thuer-awesome/wulpus/projects/README.md

# Independent projects

Projects that are related to the delivery workspace but are not part of the
WULPUS product lines stay isolated here. The current handover is the
[9959 Control Integrated Board](9959-control-integrated-board). Its source,
outputs, and audit files must not be mixed into a WULPUS v1 or PRO production
order.
