thuer-awesome/wulpus/LICENSES/README.md

# License map

The integration repository intentionally keeps the upstream license boundaries.

| Content | Applicable license | License file in this repository |
|---|---|---|
| WULPUS v1 Altium/CAD source | Solderpad Hardware License 0.51 | [`WULPUS-HW-SHL-0.51.txt`](WULPUS-HW-SHL-0.51.txt) |
| WULPUS PRO Altium/CAD source | Solderpad Hardware License 0.51 | [`WULPUS-PRO-HW-SHL-0.51.txt`](WULPUS-PRO-HW-SHL-0.51.txt) |
| WULPUS v1 host software | Apache License 2.0 | [`WULPUS-SW-Apache-2.0.txt`](WULPUS-SW-Apache-2.0.txt) |
| WULPUS PRO host software | Apache License 2.0 | [`WULPUS-PRO-SW-Apache-2.0.txt`](WULPUS-PRO-SW-Apache-2.0.txt) |
| WULPUS documentation images | Creative Commons Attribution 4.0 | [`WULPUS-DOCS-IMAGES-CC-BY-4.0.txt`](WULPUS-DOCS-IMAGES-CC-BY-4.0.txt) |
| MSP430 driverlib | Vendor/third-party terms | [`MSP430-DRIVERLIB-THIRD-PARTY.txt`](MSP430-DRIVERLIB-THIRD-PARTY.txt) |

Firmware source may include Nordic SDK headers, TI driverlib, and other
third-party material. Retain the notices shipped next to the source files when
redistributing a derivative. The integration metadata, scripts, and original
notes added here are released under Apache-2.0 unless a more specific notice
applies.
