thuer-awesome/wulpus/docs/provenance/README.md

# Reproduction-package provenance

The files in this directory preserve the package-level README, source metadata,
manifest, and original repository metadata supplied with the local reproduction
packages. They are evidence about the source snapshot, not a second canonical
copy of the CAD or firmware. The canonical files are the board-oriented trees
under `hardware/`, `firmware/`, and `software/`.
