thuer-awesome/wulpus/firmware/wulpus-pro/msp430/README.md

# WULPUS PRO source files for MSP430 Ultrasound MCU firmware project
This directory contains the source firmware files for 
- MSP430FR5043 Ultrasound MCU (`fw/msp430/wulpus_msp430_firmware`) mounted on the WULPUS PRO PCB

# How to get started?

Please refer to the `WULPUS User Manual` of the WULPUS system v 1.2.2 for the instructions on how to flash the MSP430 MCU:
`https://github.com/pulp-bio/wulpus/blob/main/docs/wulpus_user_manual.pdf`

# License
The files in the `hw/nRF52/wulpus_msp430_firmware` directory contains third-party sources that come with their own licenses (primarily BSD and Apache 2.0 License). See the respective folders and source files' headers for the licenses used.
