thuer-awesome/wulpus/firmware/wulpus-v1/msp430/README.md

# WULPUS source files for MSP430 Ultrasound MCU firmware project
This directory contains the source firmware files for 
- MSP430FR5043 Ultrasound MCU (`fw/msp430/wulpus_msp430_firmware`) mounted on the WULPUS acquisition PCB 

# How to get started?

1. Follow the file `fw/msp430/how_to_setup_msp_430_toolchain_and_flash.md` to install the toolchain and SDK
2. Follow the same file to flash the MSP430 MCU on the WULPUS acquisition PCB.

# License
The files in the `hw/nRF52/wulpus_msp430_firmware` directory contains third-party sources that come with their own licenses (primarily BSD and Apache 2.0 License). See the respective folders and source files' headers for the licenses used.
