thuer-awesome/wulpus/analysis/design-reference/PCB_LAYOUT_RULES_CN.md

# 两层 PCB 放置与布线规则

## 1. 建议板框和层定义

- 首版建议约 80 mm × 50 mm，1.0 或 1.2 mm FR-4、1 oz 铜、ENIG、阻焊覆盖过孔。不要为了复制原 WULPUS 的 17.5 mm × 24.5 mm 四层板尺寸而压缩两层验证板。
- Top：器件、短的功率回路、USB 差分、TX/RX 和控制信号。Bottom：连续的大面积回流铜为主，只在必要处走短线。
- 底层不是“无条件整板一块地”。充电/USB/ESP32 区铺 DGND，升压/驱动/HV2707/MD0101/换能器区铺 AGND_HV；两块铜只在 NT1 处连接。
- 所有从数字区进入驱动区的控制线都从 NT1 附近成束跨区，使它们的返回电流能沿紧邻的地连接闭合。禁止让信号跨越地平面槽后再绕远回流。

## 2. 推荐平面分区

从左到右或从后到前排列：

1. USB-C、USBLC6、PTC 和 BQ24074 紧邻接口。
2. 电池座、BQ 的 BAT/OUT 电容和 TPS63070 紧邻充电区。
3. ESP32-S3 位于板的另一条长边，天线端伸出板边；USB D+/D- 直接从连接器沿板边到模块。
4. NT1 位于 SYS 进入驱动区的咽喉位置。
5. LT1945、TPS61222、TPS22919 和各自电感/二极管/电容放在驱动区靠内侧。
6. MCP1416、HV2707、MD0101、换能器接口依次贴近板的换能器边；RX_OUT SMA 靠 MD0101，并远离 LT1945 SW 节点。

## 3. 关键回路优先级

- BQ24074：J1→F1→IN→输入电容的环路最短；BAT/OUT 电容的地端直接回 U2 VSS/EP。EP 下热过孔连接到底层大铜，禁止热焊盘用细颈或热焊盘花孔连接。
- TPS63070：VIN 电容、U3 VIN/PGND、L1、VOUT 电容形成一个紧凑簇。L1-L2 走线短且宽；FB 分压从输出电容正端做 Kelvin 取样，远离电感和开关铜。
- TPS61222：SYS→L2→pin5、pin4→C16→GND 两个回路紧凑；5V_RAW 只到 U6，不绕行。
- LT1945：U7 pin6、L3、D1 阳极构成的 `SW15_NODE` 铜面积尽可能小，顶层完成且下方不走任何信号。C18 紧靠 pin8/PGND；D1 阴极与 C19 正端贴近。FB2 分压远离 pin6 和电感。
- MCP1416：每颗驱动器、1 µF/100 nF 去耦和 HV2707 对应 TX 开关贴在一起。V15→去耦→驱动器→TX_BUS→开关→AGND 回路不得穿过板中央。
- RX：HV2707 RX 开关→C33/R44→MD0101→SMA 的总长度尽量短；其两侧和底层保持 AGND 连续，必要时加地过孔栅栏。RX_OUT 不与 TX_BUS、SW15_NODE、USB 时钟或 ESP32 天线平行长距离走线。

## 4. 线宽、间距与过孔起始值

以下值用于 1 oz 外层铜的首版起点，最终仍按板厂叠层、温升目标和阻抗计算调整：

| 网络类别 | 顶层建议线宽 | 说明 |
|---|---:|---|
| USB5_IN、BAT+、SYS 主干 | ≥1.0 mm | BQ 周边优先使用铜面，避免细颈 |
| 3V3 主干 | ≥0.8 mm | 模块供电处用面或多根并行短线 |
| 5V_RAW、VDD5_SW | ≥0.5 mm | 负载小但脉冲去耦回流要短 |
| V15 供电 | ≥0.3 mm | 平均电流不大，驱动器局部储能更重要 |
| TX_BUS/CHx | 0.5~0.8 mm | 短、少过孔、每路旁边有地回线 |
| RX_BUS/RX_OUT | 0.25~0.40 mm | 先保持短和连续参考地；若接 50 Ω 同轴再按叠层算阻抗 |
| 普通控制线 | 0.15~0.20 mm | 避免穿过电感和开关节点下方 |

- 常规最小工艺间距可为 0.20 mm；V15/TX 与数字信号主动保持 ≥0.50 mm，换能器连接器附近保持 ≥1.0 mm，目的是减小耦合并留装配余量。15 V 本身不需要夸大的爬电距离。
- 若后续输出升至 60 V 以上，必须依据最大工作电压、污染等级、涂覆和板厂能力重新算电气间隙/爬电距离，本表失效。
- 电源换层至少用 2 个并联过孔，建议成品孔 0.30 mm、焊盘 0.60 mm；高 di/dt 回路尽量不换层。

## 5. USB 与射频

- USB D+/D- 目标差分阻抗 90 Ω ±10%。线宽/间距必须用最终板厚、铜厚、阻焊和板厂介电常数计算，不能照抄“0.15/0.15 mm”之类通用值。
- 差分对等长、同层、少过孔，连接器到 ESD 再到 22 Ω/ESP32；不留测试点支路。两线长度差建议 <0.5 mm，间距沿全程稳定。
- USBLC6 放在连接器后第一站，GND 引脚旁至少 2 个地过孔；ST 手册明确指出 10 mm 细长地线产生的寄生电感会使钳位失效。
- ESP32 PCB 天线 keepout 上下层完全禁铜；模块天线与 LT1945、电感、换能器排线和电池相距尽可能远。不得在天线前方放金属外壳或电池。

## 6. 地、屏蔽与机械

- DGND/AGND_HV 分区的目标是管理回流路径，不是“模拟地越碎越好”。每个区域内部的底层铜必须连续，不开装饰性槽。
- HV2707 pin17 走 DGND，pin13/pin24、MCP1416、MD0101 和换能器回地走 AGND_HV。3V3/VLL 去耦回 DGND，5V/VDD 去耦回 AGND_HV。
- 板边每 5~10 mm 放地缝合过孔；TX/RX 连接器周围加密到约 2~3 mm，但天线 keepout 内禁止放置。
- SMA 边缘焊盘必须按实际板厚核对；如果采用 1.0 mm 板而封装为 1.6 mm 边缘座，机械尺寸会错误。
- 在 PCB 丝印标出：BAT 极性、NTC、所有测试点、RX_OUT、通道号、15 V、USB500 默认、受保护 1S 电池限定，以及 `NOT FOR HUMAN USE / LAB TEST ONLY`。

## 7. 布板顺序

1. 固定板框、USB/SMA/电池/换能器接口和 ESP32 天线位置。
2. 放置每个开关电源的 IC、电感、二极管和输入/输出电容，先完成最小功率环路。
3. 放 MCP1416、HV2707、MD0101 和通道连接器，先走 TX/RX。
4. 放 BQ24074 和 TPS63070，走 USB5/BAT/SYS/3V3 主干。
5. 走 USB 差分并进行阻抗/等长约束。
6. 放 NT1、划分底层地铜，再走跨区控制线。
7. 最后走低速控制、铺铜、加回流过孔和测试点；重新检查是否有信号跨地缝。

## 8. DRC 前人工检查

- 所有 IC 的裸露焊盘、NC、VSS 浮空和多地脚是否按数据手册连接。
- TPS63070 RNM、HV2707 LQFP48、MD0101 K6、USB4105 的 pin1/朝向和 land pattern 是否对照官方图纸逐项量过。
- HV_EN、BOOST5_EN、MUX_PWR_EN、TX_PULSE 是否都有硬件下拉；MUX_CLR 是否上拉。
- 任何通道是否误把 TX 和 RX 开关同时默认开启。
- `SW15_NODE` 下方是否无走线，FB 取样是否从输出电容正端取得。
- ESP32 天线 keepout 是否上下层都无铜，USB 是否有连续参考地。
- DGND 与 AGND_HV 是否只在 NT1 一处导通，所有跨区信号是否经过 NT1 附近。
