thuer-awesome/wulpus/reference/source-repository-maps/wulpus-pro/hw-README.md

# WULPUS PRO PCB design files
This directory contains the design files for the printed circuit boards (PCBs) of the WULPUS PRO project.
Each subdirectory corresponds to a separate PCB project. Inside you can find the Altium CAD design files:
- Source design files
- PDF schematics and assembly drawings (`docs` folder), 
- Fabrication outputs (`fabrication_outputs` folder):
    - Bill of Materials(.xlsx) 
    - Gerber files
    - NC drill files
    - Pick and Place files

# License
The PCB design files are licensed under Solderpad v0.51 (`SHL-0.51`) license. Please, check the `hw/LICENSE` file for details.
