thuer-awesome/wulpus/analysis/official-source-audit/design-study/MANIFEST_SHA256.csv

Path | Length | SHA256
pcb_reverse_engineering/commercial_fpga_reference/analysis/firmware/FM24CL16B_nonzero_records.csv | 367 | 070040d7545b339eee0f2d523455eee9dd12c03434a246f5d6bee777dfdbf103
pcb_reverse_engineering/commercial_fpga_reference/analysis/firmware/MEMORY_DUMP_ANALYSIS_CN.md | 2227 | d5cebd964eb397844bfc2871592d9f9edc2bbe7b80cf1e03fb61dacfa1235370
pcb_reverse_engineering/commercial_fpga_reference/analysis/firmware/W25Q80D_ascii_strings.csv | 10663 | bfedeaf28cb81a85b8454ea77de9c0812d8c0171ecb84a4d585d103069e0462d
pcb_reverse_engineering/commercial_fpga_reference/analysis/firmware/W25Q80D_CC3200_flash_canonical_1MiB.bin | 1048576 | 8c11c60c6a7c86abe0b310d417b99bf657c05531fffa54eede3458e214d76169
pcb_reverse_engineering/commercial_fpga_reference/analysis/firmware/W25Q80D_programmer_footer_2B.bin | 2 | 96a296d224f285c67bee93c30f8a309157f0daa35dc5b87e410b78630a09cfc7
pcb_reverse_engineering/commercial_fpga_reference/analysis/firmware/W25Q80D_SFDP_1024.bin | 1024 | 8c5001a3341bb43247a5b00e9c751d8a544581dc7c8dc129ab63b67b36f456b1
pcb_reverse_engineering/commercial_fpga_reference/analysis/pcb/20260725_96ARC_V7.d356 | 223718 | 51253fbab29b4babd1413a4c03633632e44d88060d4622430a852bd9d9cec5f9
pcb_reverse_engineering/commercial_fpga_reference/analysis/pcb/20260725_96ARC_V7.kicad_pcb | 3519418 | ef186f87a0cc67aa6efbe63ac40c965a234b9717b8792999dfd292cabab4e1a3
pcb_reverse_engineering/commercial_fpga_reference/analysis/pcb/20260725_96ARC_V7.kicad_prl | 2304 | bfebb5b589d1b6a3b3ff4e9ab6e0fdc397a6cd186c9a26b5d129ebcd07a3a01e
pcb_reverse_engineering/commercial_fpga_reference/analysis/pcb/20260725_96ARC_V7_import_report.json | 2629 | d95b70551f38c8a77a140c33ce4594b8f1fc6ae82c5d3ee042c932c10ccc7fc2
pcb_reverse_engineering/commercial_fpga_reference/analysis/pcb/20260725_96ARC_V7_stats.json | 5190 | 26273fa46523d95ee459a0d846cf40f6c63c66af168aaef819219870581ac888
pcb_reverse_engineering/commercial_fpga_reference/analysis/pcb/20260725_PowerDaughter_v30.d356 | 73636 | 3d5ccb692c5e7265621de7036a2335f20611d4bc59a8caebc6cf4b6452b06eca
pcb_reverse_engineering/commercial_fpga_reference/analysis/pcb/20260725_PowerDaughter_v30.kicad_pcb | 1220579 | b073dcb0ed322e55a9cb06e1ccc3fc54cf2d29a74b9d61e864742a5abd13a21a
pcb_reverse_engineering/commercial_fpga_reference/analysis/pcb/20260725_PowerDaughter_v30.kicad_prl | 2313 | 6b804854f42bdbc50f70ec8d331103986c1a0243c5651277548fbc9578bf2dad
pcb_reverse_engineering/commercial_fpga_reference/analysis/pcb/20260725_PowerDaughter_v30_import_report.json | 2487 | 1ec717288ed0ba41afb84001b00e40aaa2ccd9b1ca1c91f36ad1c389a0e7ec13
pcb_reverse_engineering/commercial_fpga_reference/analysis/pcb/20260725_PowerDaughter_v30_stats.json | 4952 | 9708e1fbf4aad868ff4b5027502a7a8295883afc8507a1642732c81a0dfc9664
pcb_reverse_engineering/commercial_fpga_reference/analysis/pcb/CONNECTOR_AND_CHANNEL_MAP_CN.md | 2248 | 7439f27845415d8f6723617d70373ce90af7c1b1311ebb27184f0bacc2374a42
pcb_reverse_engineering/commercial_fpga_reference/analysis/photos/96ARC_V7_top_component.jpg | 3944013 | b302280954f173fad734c9d27bd30d2b8e29bae445c638ed1a2a817de3922eef
pcb_reverse_engineering/commercial_fpga_reference/analysis/photos/commercial_board_photos_contact_sheet.jpg | 1893171 | a0b9a297a6ad0ff482c754ac46f5b9f18623c7b6bb6e516a4a5b5ccea2de5a41
pcb_reverse_engineering/commercial_fpga_reference/analysis/photos/PowerDaughter_v30_top_component.jpg | 2289514 | c17d5816f664cb6d88a6b4ff5ec6bbb5f6c5af682bb27587de42f3a97951df64
pcb_reverse_engineering/commercial_fpga_reference/analysis/schematic/96ARC_V7_pdf_page_1.png | 797897 | 8c30ddf372aa0c18766510f7c2f1c53baaff6bf01f0266725934fb0ca9dd2a5e
pcb_reverse_engineering/commercial_fpga_reference/analysis/schematic/96ARC_V7_pdf_page_2.png | 647276 | 49e09cf869fc2c1a0aa5cf8840a116a940f43c16644df14e61ce9437d0588bbd
pcb_reverse_engineering/commercial_fpga_reference/analysis/schematic/96ARC_V7_pdf_page_3.png | 14829 | fee73408196874731cf30b0648dc72a69cd7e8e08bd8be15d84d0775382127b1
pcb_reverse_engineering/commercial_fpga_reference/analysis/schematic/commercial_delivery_pdf_contact_sheet.png | 1052459 | 8d15213b5ad89c1046d7efcdef36fc63c6b23f46663774f1897fb5aeaf3bceeb
pcb_reverse_engineering/commercial_fpga_reference/analysis/schematic/PowerDaughter_v30_pdf_page_1.png | 428168 | 6d8ec1d15a721465175b295d8145b6309f2adaa8308355da8ae3df34db4c2257
pcb_reverse_engineering/commercial_fpga_reference/analysis/schematic/PowerDaughter_v30_pdf_page_2.png | 598329 | 4adb0f5dc7def94a45d9f572175a48083448351ef6b363e4b331dd0088e5ae7a
pcb_reverse_engineering/commercial_fpga_reference/analysis/schematic/PowerDaughter_v30_pdf_page_3.png | 14829 | fee73408196874731cf30b0648dc72a69cd7e8e08bd8be15d84d0775382127b1
pcb_reverse_engineering/commercial_fpga_reference/analysis/specs/ultrasound_spec_calculator.py | 4264 | 52ebee3e179971bd65ab6a9a6d1c669c38b53f6a681a05a4955379e43881643d
pcb_reverse_engineering/commercial_fpga_reference/source_original/MANIFEST_SHA256.csv | 12337 | f1332eb8233132825e92a6150133dcc286d4d7bc188b6dbf79df2c3ca5e08d52
pcb_reverse_engineering/commercial_fpga_reference/study/README_CN.md | 3368 | 7f7aa08f9f10f107eabb11eb4d60a9c241abfd1847fbc123f53b2252094770a0
pcb_reverse_engineering/output/pdf/Portable_Ultrasound_Three_System_Study_CN.pdf | 6753373 | 11a2c9cd69bb171fb46a95e345362da3b37aec9314ba565a8614aa55aad737b2
pcb_reverse_engineering/report/assets/reverse_reference_tx_mux.png | 177637 | 7d533b079f513c007bc858e43202df90126312d61a9316aa45ae25f3f949202b
pcb_reverse_engineering/report/assets/wulpus_hv_topology.png | 429315 | 04f356af4a13b77d1f360149f0510f2d5f2c78cb9eaba8ca39e834e19658df37
pcb_reverse_engineering/report/assets/wulpus_pro_hv_topology.png | 427441 | 7455e0758689304ba58e3108651f87ec642237bf4b006d09b34f6707bc1afd31
pcb_reverse_engineering/report/Build_Report.cmd | 560 | 6a27e35e101413052c996e0753cd7089385b89f4bf7a7ae4d6e8d483b179d4bf
pcb_reverse_engineering/report/portable_ultrasound_three_system_study_cn.typ | 41744 | 52fc896348707f9645f481f2a5fd21ade720cf762e89ba5f884054f83c2d619a
pcb_reverse_engineering/tools/archive_commercial_fpga.ps1 | 2989 | ebe54ba5d76f4df0231f1d640715e83270b29b96381b7d12f1d9bdfc6efce641
pcb_reverse_engineering/tools/kicad_portable/analysis/converted/wulpus/acquisition_pcb/pcb/PCB1.import_report.json | 2932 | a77e5778ca47408303cd2f24459794831ad1d7cf2db3c5cd6afe92f492beac8a
pcb_reverse_engineering/tools/kicad_portable/analysis/converted/wulpus/acquisition_pcb/pcb/PCB1.kicad_pcb | 5712633 | 6749f520748b88a9bf1e401fff7e149c53b6ddad14385b484b39414388fca86b
pcb_reverse_engineering/tools/kicad_portable/analysis/converted/wulpus/acquisition_pcb/pcb/PCB1.kicad_prl | 2291 | 83a133be35a613c2eb8d96ee3f2236dd53320a571a03b014da42efa82aeaf204
pcb_reverse_engineering/tools/kicad_portable/analysis/converted/wulpus/acquisition_pcb/pcb/plots/legacy_acquisition_layers.pdf | 1065693 | d9d8411842b473a5a919aaddc590b5712f9203bba3050b1303f4de4977bf0a43
pcb_reverse_engineering/tools/kicad_portable/analysis/converted/wulpus/acquisition_pcb/pcb/renders/legacy_acquisition_bottom.png | 545174 | d0a0564d986316c08c8f26dce2effdb226e90acea7682141d60afbb7ff465548
pcb_reverse_engineering/tools/kicad_portable/analysis/converted/wulpus/acquisition_pcb/pcb/renders/legacy_acquisition_top.png | 701188 | 9f8e93d7f57b1a429a6939cace4fc7f0eb6729d04ff05a1a1398bcc6bd265e14
pcb_reverse_engineering/tools/kicad_portable/analysis/converted/wulpus/acquisition_pcb/pcb/reports/legacy_acquisition_drc.json | 1009773 | 271967be9ea74c1beafb4ebe5faa3810b43f8cc41de5666cd3ce9136014cec7b
pcb_reverse_engineering/tools/kicad_portable/analysis/converted/wulpus/acquisition_pcb/pcb/reports/legacy_acquisition_drc.rpt | 319298 | fd10fd6c5074e02ffbc01f87e6485bb80fcfe05170000ed295fdbac350c2a6e0
pcb_reverse_engineering/tools/kicad_portable/analysis/converted/wulpus/acquisition_pcb/schematic/00_POWER.kicad_sch | 976511 | b8bcaa9546409b54fd0802017a77c14b487b82a63860938db1ed0c92d2f38e7c
pcb_reverse_engineering/tools/kicad_portable/analysis/converted/wulpus/acquisition_pcb/schematic/01_NRF52.kicad_sch | 741215 | 3d77582a4fad53b8f1aec50650968f05ea9cb1f217db0f5a8cb34867f48ae414
pcb_reverse_engineering/tools/kicad_portable/analysis/converted/wulpus/acquisition_pcb/schematic/02_MSP430.kicad_sch | 806538 | 603da13dfb3c188dcc4017c42bae0ea7e92ff547ffedde6f1f8a2542fc7538c7
pcb_reverse_engineering/tools/kicad_portable/analysis/converted/wulpus/acquisition_pcb/schematic/exports/00_POWER.pdf | 263874 | 221924c0f82e645514de216ca0aedc48982c4964fe4eaed3f62d7d6e26121463
pcb_reverse_engineering/tools/kicad_portable/analysis/converted/wulpus/acquisition_pcb/schematic/exports/00_POWER_bom.csv | 3113 | ba1a683f3724f12f6d93ef3740a617f1f6d751dcedba60e4d63d8599ffaf6069
pcb_reverse_engineering/tools/kicad_portable/analysis/converted/wulpus/acquisition_pcb/schematic/exports/00_POWER_erc.json | 324328 | 38e9868bb3adf8f79e4755daac1dfa3c32ae97bbfe7b2ed42da5df6d582590f3
pcb_reverse_engineering/tools/kicad_portable/analysis/converted/wulpus/acquisition_pcb/schematic/exports/00_POWER_erc.rpt | 74403 | 068fe128cc00b86a7d5781af638df499b965998ac4027cd582a41a7cc657d8d2
pcb_reverse_engineering/tools/kicad_portable/analysis/converted/wulpus/acquisition_pcb/schematic/exports/00_POWER_netlist.xml | 213392 | 113af3046a8ce231d5336998dbc6a550c0a93965af9600c1915077d55a982dbd
pcb_reverse_engineering/tools/kicad_portable/analysis/converted/wulpus/acquisition_pcb/schematic/exports/01_NRF52.pdf | 245642 | fb6ecd128f62dd4e051b68ab31b76015385fbe7b45cd33a526f01756cdd29fc4
pcb_reverse_engineering/tools/kicad_portable/analysis/converted/wulpus/acquisition_pcb/schematic/exports/01_NRF52_bom.csv | 1599 | 373fbbcea659f845f85498ae1d22d3a70b77e4c57341e4b68e43e5f8f24c1607
pcb_reverse_engineering/tools/kicad_portable/analysis/converted/wulpus/acquisition_pcb/schematic/exports/01_NRF52_erc.json | 286386 | f10ccf182fe7c8c2dcf4a25c755188230d863ed93956d0b08d9ec481805ae5cf
pcb_reverse_engineering/tools/kicad_portable/analysis/converted/wulpus/acquisition_pcb/schematic/exports/01_NRF52_erc.rpt | 64027 | 7293849b7f973e39682c2c7c3a6f081a4a7adf3686df84d546cee93392f1ee42
pcb_reverse_engineering/tools/kicad_portable/analysis/converted/wulpus/acquisition_pcb/schematic/exports/01_NRF52_netlist.xml | 124934 | b9766175c78c05737d28076b77abe981aacfd95b72e046fa8ba07384fd68d2f1
pcb_reverse_engineering/tools/kicad_portable/analysis/converted/wulpus/acquisition_pcb/schematic/exports/02_MSP430.pdf | 269352 | 0684178063d5d83434e76b93777eff852d08b9e2b61eac7268b9dbf418317163
pcb_reverse_engineering/tools/kicad_portable/analysis/converted/wulpus/acquisition_pcb/schematic/exports/02_MSP430_bom.csv | 1968 | 700b7d1f786df966843ab64f633f34be4e7db57349446231335507676483866d
pcb_reverse_engineering/tools/kicad_portable/analysis/converted/wulpus/acquisition_pcb/schematic/exports/02_MSP430_erc.json | 350100 | c39b56fc04fe84bec7c61995df7a8417faf1528f708df52b9e43ee815a79874d
pcb_reverse_engineering/tools/kicad_portable/analysis/converted/wulpus/acquisition_pcb/schematic/exports/02_MSP430_erc.rpt | 78534 | 0bb30ee96722ec7e72b422abe0fa6b6056973ea8a52dbd178ff0bab4f8740405
pcb_reverse_engineering/tools/kicad_portable/analysis/converted/wulpus/acquisition_pcb/schematic/exports/02_MSP430_netlist.xml | 150643 | b9b900456a43a83087423f2118c045bab4c2630a59fccad53641831d9959cf5e
pcb_reverse_engineering/tools/kicad_portable/analysis/converted/wulpus/hv_pcb/pcb/PCB1.import_report.json | 2929 | ae3ae7302fe6dc974df3091d935b7daa64dde502af3406f4932a878b9d35a3f3
pcb_reverse_engineering/tools/kicad_portable/analysis/converted/wulpus/hv_pcb/pcb/PCB1.kicad_pcb | 2781457 | 0742b30313925734417916c6eca59869eb56a8679048abcd24ff77be33bd3d33
pcb_reverse_engineering/tools/kicad_portable/analysis/converted/wulpus/hv_pcb/pcb/PCB1.kicad_prl | 2291 | 83a133be35a613c2eb8d96ee3f2236dd53320a571a03b014da42efa82aeaf204
pcb_reverse_engineering/tools/kicad_portable/analysis/converted/wulpus/hv_pcb/pcb/plots/legacy_hv_layers.pdf | 456144 | 31bda550b14f2d634774d3514fef547887deac9785393132b279080fcaa22742
pcb_reverse_engineering/tools/kicad_portable/analysis/converted/wulpus/hv_pcb/pcb/renders/legacy_hv_bottom.png | 637488 | 81098f1f070407469c299a77f2ab726056e20c4023c0c7cea0bdd6b4c1784d7f
pcb_reverse_engineering/tools/kicad_portable/analysis/converted/wulpus/hv_pcb/pcb/renders/legacy_hv_top.png | 555611 | 88577ba9b5b483be96ab11934fd9813d6eadcf90b8e5fc73062d21e755b03b7f
pcb_reverse_engineering/tools/kicad_portable/analysis/converted/wulpus/hv_pcb/pcb/reports/legacy_hv_drc.json | 671817 | 4217bd0ee987ff5bc5b2728ed68cb6066316d83bcf87e4b997e401bd3f0a7c93
pcb_reverse_engineering/tools/kicad_portable/analysis/converted/wulpus/hv_pcb/pcb/reports/legacy_hv_drc.rpt | 205362 | 6d74b9d5212d9fed496a3a99409ef3600c367005d5ec3752a64f20dc6331a54c
pcb_reverse_engineering/tools/kicad_portable/analysis/converted/wulpus_pro/acquisition_dev_board/pcb/plots/pro_acquisition_dev_layers.pdf | 1645580 | 24a5a2677adfda0f15a20c6798212993680a875072d47f87a432a86b69f7747d
pcb_reverse_engineering/tools/kicad_portable/analysis/converted/wulpus_pro/acquisition_dev_board/pcb/renders/pro_acquisition_dev_bottom.png | 425574 | 4a984d006d4750b0437091f58d41f17764e4d8b9d129f91edd3ce6e9b804233b
pcb_reverse_engineering/tools/kicad_portable/analysis/converted/wulpus_pro/acquisition_dev_board/pcb/renders/pro_acquisition_dev_top.png | 390529 | 921314b2b7bcf36c469936f56029a7d9cfbafaa180f50fc3b383e43178c2256f
pcb_reverse_engineering/tools/kicad_portable/analysis/converted/wulpus_pro/acquisition_dev_board/pcb/reports/pro_acquisition_dev_drc.json | 1324913 | 00267ca0ac211b42625a857f2a9e161930a0e14f3a3f8a9c2e0eaf00012bc57e
pcb_reverse_engineering/tools/kicad_portable/analysis/converted/wulpus_pro/acquisition_dev_board/pcb/reports/pro_acquisition_dev_drc.rpt | 435362 | ca7d81d56b5412cea716342f807b8d3a50613d90f2940d98d11af6fa8d6d7916
pcb_reverse_engineering/tools/kicad_portable/analysis/converted/wulpus_pro/acquisition_dev_board/pcb/wulpus_pro_acq.import_report.json | 2929 | 3e935ce17401848a643b8b6b54d4f27da59ebae47903f4e5d1fae5a121303065
pcb_reverse_engineering/tools/kicad_portable/analysis/converted/wulpus_pro/acquisition_dev_board/pcb/wulpus_pro_acq.kicad_pcb | 6460818 | a2e89b6541292d7d3aebd34b20d9db29407c59b6506489de9d27552bf557f3e9
pcb_reverse_engineering/tools/kicad_portable/analysis/converted/wulpus_pro/acquisition_dev_board/pcb/wulpus_pro_acq.kicad_prl | 2301 | 3f5df1be51ca24f9e4a9f0fdae198ccc9b8b9a7356756d3ed5d92dff77027008
pcb_reverse_engineering/tools/kicad_portable/analysis/converted/wulpus_pro/acquisition_dev_board/project_import/BGA4C40P2X2_78X78X50.PcbLib | 108032 | c22f471d92d2a79b36096e2eec41cdbd63f635cc79ee03e838c62c398354e11d
pcb_reverse_engineering/tools/kicad_portable/analysis/converted/wulpus_pro/acquisition_dev_board/project_import/BGA6C50P2X3_89X139X50.PcbLib | 117760 | 29dc9899cb00002ef8c9a5385e8f9a7f38067c0cc19734bb13311b54b600b644
pcb_reverse_engineering/tools/kicad_portable/analysis/converted/wulpus_pro/acquisition_dev_board/project_import/cmut_conn.PcbLib | 700928 | acc128b32576a68ef328b1eb50df2178bd8ab345ef212a3e3a7b95a2a9d7aad6
pcb_reverse_engineering/tools/kicad_portable/analysis/converted/wulpus_pro/acquisition_dev_board/project_import/cmut_conn.SCHLIB | 8704 | 5cd163821a95297a6316bdfced2d3e86b5f6271cd18c5a8068413e61e286f5ac
pcb_reverse_engineering/tools/kicad_portable/analysis/converted/wulpus_pro/acquisition_dev_board/project_import/exports/by_sheet/host_connector_bom.csv | 859 | 217724c10a83f269230457205e814fdf4c9465b5797edbb7956e82f8a0f70ca9
pcb_reverse_engineering/tools/kicad_portable/analysis/converted/wulpus_pro/acquisition_dev_board/project_import/exports/by_sheet/host_connector_netlist.xml | 92505 | f89cb82478f586164bb3f3a8d42b189128fd9e0d03d4449415ba3080aed1c63e
pcb_reverse_engineering/tools/kicad_portable/analysis/converted/wulpus_pro/acquisition_dev_board/project_import/exports/by_sheet/hv_mux_tr_sw_bom.csv | 1935 | 3525bb1869ccee34736cff5af7bb94298bf212aa5c9b52d099eb9199d6aae8e7
pcb_reverse_engineering/tools/kicad_portable/analysis/converted/wulpus_pro/acquisition_dev_board/project_import/exports/by_sheet/hv_mux_tr_sw_netlist.xml | 178702 | 3cdc6fdcfc393b34cb3edcf395422b87e463495b3f04e690cc5b2794b6a49eaf
pcb_reverse_engineering/tools/kicad_portable/analysis/converted/wulpus_pro/acquisition_dev_board/project_import/exports/by_sheet/msp430_bom.csv | 1821 | 17e6f041877fa2b25f371e7be85d2e33710c82a45aa1262927e3ffdf1a5e575d
pcb_reverse_engineering/tools/kicad_portable/analysis/converted/wulpus_pro/acquisition_dev_board/project_import/exports/by_sheet/msp430_netlist.xml | 145034 | 4ce7754f1b6ac2f7f0e5717de7329173d62e6f54c2b8eeeb353e10b4531cb2ab
pcb_reverse_engineering/tools/kicad_portable/analysis/converted/wulpus_pro/acquisition_dev_board/project_import/exports/by_sheet/power_bom.csv | 1455 | 8c6249170e04a53d534a5eae3f4a1aa59b0ce80831f813e370f9bd2b3036a36a
pcb_reverse_engineering/tools/kicad_portable/analysis/converted/wulpus_pro/acquisition_dev_board/project_import/exports/by_sheet/power_netlist.xml | 93402 | 5b5f8199e4ebb31d31271d757eaa84d3bae4a5c635cbcebcf0541678bc213614
pcb_reverse_engineering/tools/kicad_portable/analysis/converted/wulpus_pro/acquisition_dev_board/project_import/exports/by_sheet/rx_path_bom.csv | 2268 | 30ef491bb96d38eaa2a588912534c569ca038c249ceed59ef2766e0fc655c3cd
pcb_reverse_engineering/tools/kicad_portable/analysis/converted/wulpus_pro/acquisition_dev_board/project_import/exports/by_sheet/rx_path_lp_filter_bom.csv | 397 | f2e546abd5662018644f7ab38fd4d0c38a189a1b22e79f69ab26023ed7f4a35a
pcb_reverse_engineering/tools/kicad_portable/analysis/converted/wulpus_pro/acquisition_dev_board/project_import/exports/by_sheet/rx_path_lp_filter_netlist.xml | 34548 | ee4d92562acc9a8591c16b838ac49d0c9014e1e547ceecf9f2dad90bc9f0834e
pcb_reverse_engineering/tools/kicad_portable/analysis/converted/wulpus_pro/acquisition_dev_board/project_import/exports/by_sheet/rx_path_netlist.xml | 184906 | 2f15cc807399291a60d4080ebfddc866d8b0b3f905a1351a3b5f911dc4e8618b
pcb_reverse_engineering/tools/kicad_portable/analysis/converted/wulpus_pro/acquisition_dev_board/project_import/exports/by_sheet/tx_path_bom.csv | 639 | 3bf53ecfe70894fb740445d90043fbebb23dc40334e24bad83bbd6e07bfe4ca8
pcb_reverse_engineering/tools/kicad_portable/analysis/converted/wulpus_pro/acquisition_dev_board/project_import/exports/by_sheet/tx_path_netlist.xml | 52215 | 842c6fcc79bbf6afbccc1b9b404d5a1916b5de18a05ce9b4b64e4f32031669ef
pcb_reverse_engineering/tools/kicad_portable/analysis/converted/wulpus_pro/acquisition_dev_board/project_import/exports/wulpus_pro_acq_bom.csv | 17645 | 68df32692dfcf10edd951267c8513d2fe3086a57a2f492ce5ba261a92adfcf47
pcb_reverse_engineering/tools/kicad_portable/analysis/converted/wulpus_pro/acquisition_dev_board/project_import/exports/wulpus_pro_acq_erc.json | 1834660 | 587aa899ff56866908a5766f4fc952526be823bd6b81f2fac7dc676986310df1
pcb_reverse_engineering/tools/kicad_portable/analysis/converted/wulpus_pro/acquisition_dev_board/project_import/exports/wulpus_pro_acq_erc.rpt | 407872 | f8051917cf5d75513d4f2863d2dbedc75a807864ff3fa2dfbc2fc1142746291c
pcb_reverse_engineering/tools/kicad_portable/analysis/converted/wulpus_pro/acquisition_dev_board/project_import/exports/wulpus_pro_acq_netlist.xml | 747055 | c9534be068e3d0c1ec58adf0e84e244688687fb1f92a3d83135a7340b7b3b624
pcb_reverse_engineering/tools/kicad_portable/analysis/converted/wulpus_pro/acquisition_dev_board/project_import/exports/wulpus_pro_acq_schematics.pdf | 1127365 | d1192bbddb2e15759ca8b332cabb07bb3ed35bf7d0539d16ed0f6deffed0be6b
pcb_reverse_engineering/tools/kicad_portable/analysis/converted/wulpus_pro/acquisition_dev_board/project_import/fp-lib-table | 1139 | 9922bfd6a88baeb91d5fdef9b45887e80c82b8681d24ef01b5493ebef89f77be
pcb_reverse_engineering/tools/kicad_portable/analysis/converted/wulpus_pro/acquisition_dev_board/project_import/host_connector.kicad_sch | 682183 | c7170714603bf50946e2ec9ac09982e442fc6de69bd575a7c0982c206cb7e29e
pcb_reverse_engineering/tools/kicad_portable/analysis/converted/wulpus_pro/acquisition_dev_board/project_import/host_connectors.PcbLib | 1213440 | acad6a74dd6a8495a141a975f7169041701d7eaff2573e197f6a0a130cb0b5f7
pcb_reverse_engineering/tools/kicad_portable/analysis/converted/wulpus_pro/acquisition_dev_board/project_import/host_connectors.SCHLIB | 11776 | 102362748d612ce67be757d3e904711b616b7681c33edc499948eb5da018bb1d
pcb_reverse_engineering/tools/kicad_portable/analysis/converted/wulpus_pro/acquisition_dev_board/project_import/hv_mux_tr_sw.kicad_sch | 961110 | e829aaf48dd82ebb1655ea69f54ff85eecb14257645116e4d368e47f5b6327cb
pcb_reverse_engineering/tools/kicad_portable/analysis/converted/wulpus_pro/acquisition_dev_board/project_import/IXDD609D2TR.SchLib | 6144 | c51cb3a38b7af81b0d4152903f3d66dc5938d3604388790b0f4cbd7cf59c88a2
pcb_reverse_engineering/tools/kicad_portable/analysis/converted/wulpus_pro/acquisition_dev_board/project_import/MD01000.SchLib | 4608 | d397712aba515b64de82bd36c447126621171b1cc2eb2e86ce2ea86145e83207
pcb_reverse_engineering/tools/kicad_portable/analysis/converted/wulpus_pro/acquisition_dev_board/project_import/MD0100N8-G.PcbLib | 126976 | 9aabd920d1f1d9fc099e4dfbbb9f8e5af5de8feb133d782beb41ccff0a2abeb1
pcb_reverse_engineering/tools/kicad_portable/analysis/converted/wulpus_pro/acquisition_dev_board/project_import/msp430.kicad_sch | 819150 | 818f716a57e1b8b5016834811b336f454fa5ae5f222bc21a96bccedb51c8b432
pcb_reverse_engineering/tools/kicad_portable/analysis/converted/wulpus_pro/acquisition_dev_board/project_import/power.kicad_sch | 11279054 | cb534d3767addbe95da3565d0f00e73d1a9f31ff208432c8e50f2348acd115bc
pcb_reverse_engineering/tools/kicad_portable/analysis/converted/wulpus_pro/acquisition_dev_board/project_import/rx_path.kicad_sch | 908695 | 9c83d51578e54c1fab436debe2d68a53c4a25deaea28c9409c9101f1275f0308
pcb_reverse_engineering/tools/kicad_portable/analysis/converted/wulpus_pro/acquisition_dev_board/project_import/rx_path_lp_filter.kicad_sch | 490725 | d5b20f21b732a297c4cc498a9aa97e4e9004b60f14b7fe571f9213cd575fb60d
pcb_reverse_engineering/tools/kicad_portable/analysis/converted/wulpus_pro/acquisition_dev_board/project_import/SN74AVC4T774RSVR.PcbLib | 119808 | 1f9da7d4f1bc6adf9ea06e2c933aaef9253050360a404a842f78874000ed99f2
pcb_reverse_engineering/tools/kicad_portable/analysis/converted/wulpus_pro/acquisition_dev_board/project_import/SN74AVC4T774RSVR.SchLib | 6656 | a439bfdc923fbe99df592ee73b7e6c5c56bd39483023f8a24d8a80eddeed49a4
pcb_reverse_engineering/tools/kicad_portable/analysis/converted/wulpus_pro/acquisition_dev_board/project_import/SON95P500X400X100-9N.PcbLib | 124928 | ddebea1f4f52852047b07af19f212b2b8bbaa39a401824550de89fbe96825ef1
pcb_reverse_engineering/tools/kicad_portable/analysis/converted/wulpus_pro/acquisition_dev_board/project_import/sym-lib-table | 1005 | 60b39794b381e9bbde0552ad793e665e331c42a4779ca9e1397a853b09c48508
pcb_reverse_engineering/tools/kicad_portable/analysis/converted/wulpus_pro/acquisition_dev_board/project_import/TPS22916CYFPR.SchLib | 5632 | 11003eb6fcaa145b3b818f8893c73885777c65f5d587e13c0a6f03ece3cabb21
pcb_reverse_engineering/tools/kicad_portable/analysis/converted/wulpus_pro/acquisition_dev_board/project_import/TS5A3159AYZPR.SchLib | 5632 | 99073d86e6e219fa28cdf2596b43d4a8f75d8594f8cc16d7af9630ec8036437c
pcb_reverse_engineering/tools/kicad_portable/analysis/converted/wulpus_pro/acquisition_dev_board/project_import/tx_path.kicad_sch | 538843 | 164a25fb4803ff832ff330354ee1331876c5c3b50ad5c9eef8e5f9c3e4fdf52b
pcb_reverse_engineering/tools/kicad_portable/analysis/converted/wulpus_pro/acquisition_dev_board/project_import/wulpus.PcbLib | 4563456 | d94387f7f5c43d74be027a604b6ae50032ee617abcc7da00cba1c30b2b334513
pcb_reverse_engineering/tools/kicad_portable/analysis/converted/wulpus_pro/acquisition_dev_board/project_import/wulpus.SCHLIB | 447488 | d72aee1763a599156d616c9648a60cb255cb78bdc6ae106005368750e52ead24
pcb_reverse_engineering/tools/kicad_portable/analysis/converted/wulpus_pro/acquisition_dev_board/project_import/wulpus_hv.PcbLib | 2820096 | 19cba960b7d1810eb9bc59c105c83a91f1f6b6f2ca041621cd169c395651249e
pcb_reverse_engineering/tools/kicad_portable/analysis/converted/wulpus_pro/acquisition_dev_board/project_import/wulpus_hv.SCHLIB | 175616 | 03fdde75d6b5de48a1b9fe51c014b14936bd234d779e327c7eb118007f890653
pcb_reverse_engineering/tools/kicad_portable/analysis/converted/wulpus_pro/acquisition_dev_board/project_import/wulpus_pro_acq_pcb.kicad_pcb | 6463242 | a3159c344faa3abca2e61e3cbb20977c7f74147a9a7fbabd13d78f0f889b3244
pcb_reverse_engineering/tools/kicad_portable/analysis/converted/wulpus_pro/acquisition_dev_board/project_import/wulpus_pro_acq_pcb.kicad_prl | 2780 | 57e3303ce8c96887e6fda87868004f27313dee4d2c6d0750b355cbd781457489
pcb_reverse_engineering/tools/kicad_portable/analysis/converted/wulpus_pro/acquisition_dev_board/project_import/wulpus_pro_acq_pcb.kicad_pro | 20923 | 10e1422e4529d90c72bc634a74301f7d4667a008a1dc8c6c94d9d2741a66d5ae
pcb_reverse_engineering/tools/kicad_portable/analysis/converted/wulpus_pro/acquisition_dev_board/project_import/wulpus_pro_acq_pcb.kicad_sch | 442224 | ac278b73304454bd3cdfe81eb00a0d9f3da8cf0935ff84e1d89e3073e828bd9b
pcb_reverse_engineering/tools/kicad_portable/analysis/converted/wulpus_pro/polycmut_adapter/pcb/PCB1.import_report.json | 2748 | 0cd1de9ef7e2779f58a310fe7ae6f4a643750c14696a68e1b80fbd70dfa6bdb6
pcb_reverse_engineering/tools/kicad_portable/analysis/converted/wulpus_pro/polycmut_adapter/pcb/PCB1.kicad_pcb | 939962 | 3350b871a26003bd1d2f4d8483a6345445c193a4f9fb54b428b4d85136925578
pcb_reverse_engineering/tools/kicad_portable/analysis/converted/wulpus_pro/polycmut_adapter/pcb/PCB1.kicad_prl | 2291 | 83a133be35a613c2eb8d96ee3f2236dd53320a571a03b014da42efa82aeaf204
pcb_reverse_engineering/tools/kicad_portable/analysis/converted/wulpus_pro/polycmut_adapter/pcb/plots/pro_polycmut_adapter_layers.pdf | 160174 | 8c006f5b755adcc79da561db2ac318524f4c18a934564e8587693e950f48cc61
pcb_reverse_engineering/tools/kicad_portable/analysis/converted/wulpus_pro/polycmut_adapter/pcb/renders/pro_polycmut_adapter_bottom.png | 297350 | 0f4534f4e5da06e85bed1a51ea0b9877c0ebd0ae81dc2bd0ade038e6447faa00
pcb_reverse_engineering/tools/kicad_portable/analysis/converted/wulpus_pro/polycmut_adapter/pcb/renders/pro_polycmut_adapter_top.png | 293547 | 17f3a209dd9881618bf9495f17d2f68641d11734cb7dabfcc48e0c45499192f5
pcb_reverse_engineering/tools/kicad_portable/analysis/converted/wulpus_pro/polycmut_adapter/pcb/reports/locale_test_drc.json | 298487 | d3afcdb2f4416c99d2b27e4dac2c22e200b2019067eec7e6cad6f1f5a486426b
pcb_reverse_engineering/tools/kicad_portable/analysis/converted/wulpus_pro/polycmut_adapter/pcb/reports/pro_polycmut_adapter_drc.json | 298489 | c3ceb343ca28333be3e3d2892c29de5081b54f47e7c9caa805c2e45e00380ade
pcb_reverse_engineering/tools/kicad_portable/analysis/converted/wulpus_pro/polycmut_adapter/pcb/reports/pro_polycmut_adapter_drc.rpt | 95197 | 2bd82680d9a1ebe17a3e08a21b83f31ecb2d23106edd52e6fb6377218fb0f24b
pcb_reverse_engineering/tools/kicad_portable/analysis/converted/wulpus_pro/polycmut_adapter/schematic/exports/Sheet1.pdf | 134611 | 5753034eba934870f9dc0cceb6dfdab516f0578a7c4e7326828c213f8830050b
pcb_reverse_engineering/tools/kicad_portable/analysis/converted/wulpus_pro/polycmut_adapter/schematic/exports/Sheet1_bom.csv | 919 | 5a2915a2d404eb73b2bd67767013a2690ff2925a09413d4fc085a5e5a9d6f9c6
pcb_reverse_engineering/tools/kicad_portable/analysis/converted/wulpus_pro/polycmut_adapter/schematic/exports/Sheet1_erc.json | 173565 | 3b8cc76335e94dffdb9f92cf5da78083a22a5de60de3857395e3e523faa36268
pcb_reverse_engineering/tools/kicad_portable/analysis/converted/wulpus_pro/polycmut_adapter/schematic/exports/Sheet1_erc.rpt | 36344 | 2022d52da951a67c3121a489de357da8a9cd6f24f7198e16d56cec408fb20b27
pcb_reverse_engineering/tools/kicad_portable/analysis/converted/wulpus_pro/polycmut_adapter/schematic/exports/Sheet1_netlist.xml | 62446 | 709ff0c5d193a99c499fe22fa8b27c165dfde92d774f6e92397a8eb31d6d2a5b
pcb_reverse_engineering/tools/kicad_portable/analysis/converted/wulpus_pro/polycmut_adapter/schematic/Sheet1.kicad_prl | 2293 | a0a3ad6249c3f0e98c4d71217f63d15679ed09e4b79a0eb4ac3559d9e3638952
pcb_reverse_engineering/tools/kicad_portable/analysis/converted/wulpus_pro/polycmut_adapter/schematic/Sheet1.kicad_pro | 9199 | 642eea59cad7ba1e13137616af9ea9f89445f3941f9a9c9a58c8dc1419b99363
pcb_reverse_engineering/tools/kicad_portable/analysis/converted/wulpus_pro/polycmut_adapter/schematic/Sheet1.kicad_sch | 844902 | ecf4fbe8936d795f50f24b3c778936ccacd428d79be5f3c16a08ac24b646732a
pcb_reverse_engineering/tools/kicad_portable/analysis/study/01_SYSTEM_COMPARISON_CN.md | 5352 | 70290c53801dc0953abf61324b6e35dcffca607ad18315924877278bfa2cf3b7
pcb_reverse_engineering/tools/kicad_portable/analysis/study/02_SIGNAL_CHAIN_AND_TIMING_CN.md | 5094 | 780bc6ff7fb371b27e46f6e94a6658228afaca536404c6892d8e6b3f39c4413c
pcb_reverse_engineering/tools/kicad_portable/analysis/study/03_FIRMWARE_HARDWARE_MAP_CN.md | 5258 | 4609dcbb8195ed283fae3d7695144eb1166ba66c103d4de2cc2c2cc2816110a2
pcb_reverse_engineering/tools/kicad_portable/analysis/study/04_COMPONENT_CROSS_REFERENCE.csv | 3327 | a9219fa2054cc608104337f0d0d2d1273b0b969c33759352f6d94584e8e3894d
pcb_reverse_engineering/tools/kicad_portable/analysis/study/05_EVIDENCE_AND_STATUS_CN.md | 4676 | b0838274e2f6300aac4bc8b43351b827d9b0e0000efe6becca59d7ecf7f4174b
pcb_reverse_engineering/tools/kicad_portable/analysis/study/06_STUDY_SEQUENCE_CN.md | 4403 | 2e3e70ac32ab8d889af50728b7835108b83cf949f3a7d18fccb704e9e6659a99
pcb_reverse_engineering/tools/kicad_portable/analysis/study/README_CN.md | 3688 | f364727172e34b39150c1b9ebbd32d9b12211888edfc1ede1817781271423de3
pcb_reverse_engineering/tools/typst_portable/app/typst-x86_64-pc-windows-msvc/LICENSE | 9723 | 62c7a1e35f56406896d7aa7ca52d0cc0d272ac022b5d2796e7d6905db8a3636a
pcb_reverse_engineering/tools/typst_portable/app/typst-x86_64-pc-windows-msvc/NOTICE | 21066 | 1778244777547c281b6f5fa9fc0c18ab21f8d4491c803f64e09046800f5fcb26
pcb_reverse_engineering/tools/typst_portable/app/typst-x86_64-pc-windows-msvc/README.md | 12004 | ddaf0de156f6a442c7f831202cd55583614df4cc3cfb4b16e95162c7eb11e653
pcb_reverse_engineering/tools/typst_portable/app/typst-x86_64-pc-windows-msvc/typst.exe | 52487680 | 081217a463adb006f8894b44227fe4b9c9e91fc85f5463d5948e8370db9bb31e
pcb_reverse_engineering/tools/typst_portable/download/typst-x86_64-pc-windows-msvc-v0.15.1.zip | 22463684 | 19ce3551153c2fe7ee9fa2f95208310c8f4d3209fedb699e0333faf8913f6736
pcb_reverse_engineering/tools/typst_portable/README_TYPST_PORTABLE_CN.md | 815 | c140e454a43e3b815c20a6a340fa042d46b8989c6d325e5dfdbd2a17b45923a7
