thuer-awesome/wulpus/docs/manufacturing/missing-components/BOM_missing_parts_audit_20260823.md

# Y19 / Y20 未贴器件补贴与替代审计（2026-08-23）

## 结论

- Y19（HV）用户表列出的 7 个实际 SMT 位号：`U4、C12、C14、C18、C21、R7、L2`，全部存在于当前官方 BOM、CPL、Fabrication-ready 坐标和 PCB 焊盘中，当前官方 DNP 只有 `C9、C10、C11、C16、C20、R9`。
- Y20（Acquisition）用户表列出的 18 个实际 SMT 位号：`J3、J4、L3、C1、C4、C8、C9、C50、C39、R2、R19、R20、R14、R26、R28、R30、E1、U6`，全部存在于当前官方 BOM、CPL、Fabrication-ready 坐标和 PCB 焊盘中，当前 DNP 只有 `R3、R21、R32、R33、C5、C46`。
- Y20 的 `P1/P2` 是 1x3 通孔排针，官方 README 明确排除出 SMT BOM/CPL，需主板贴片后手焊，不是漏贴 SMT。
- 当前查询日只有 Samtec 精确料号 `LSHM-120-02.5-L-DV-A-N-K-TR` 在立创可直接按原型号采购（C6287797，101 件）。其余精确料号均无库存、未命中或不适合直接替换；候选替代均需工程签核后才能改 BOM。

## 厂家执行规则

1. 先按本清单的官方 MPN、封装、面别、X/Y、Rotation 补齐全部 25 个实际贴装位号。
2. 决策等级 A 可直接按原型号下单；B 只能在工程确认候选料的 datasheet、DC-bias/电流/功率/阻值误差、焊盘和首件测试后替换；C 禁止未经批准替换。
3. 禁止用 HV2708 替代 HV2707；禁止用普通天线替代 NN03-320；禁止用 FPF2106 直接替代 XC8102；禁止把 L3 的 10uH、±20%、1Ω 候选当成等料。
4. 补贴完成后执行 AOI、焊点/共面度检查，并分级上电检查 3V3、5V、15V/HV；对 Y20 追加 nRF 射频、晶振起振、I2C 默认状态、RX 带宽和连接器配对检查。

## 等参数候选摘要

| 官方MPN | LCSC精确库存 | 工程候选 | 结论 |
|---|---|---|---|
| C1608X5R1H105K080AB | 精确未命中；TDK M 变体 C3875582 为 0 | C342988（2760）、C77386（59880） | B；需 DC-bias/焊盘/高度确认 |
| ERJ-2RKF1783X | C3025696，0 | C185459（11800） | B；候选额定功率 62.5mW，需反馈功耗核算 |
| NR3012T4R7M | 精确未命中 | C6364788（610）、C42427987（470） | B；需饱和/温升电流、DCR、稳定性确认 |
| C1608X5R1A106K080AC | C2167467，0 / Not available | C19702（6105160）、C77044（199990） | B；需 DC-bias、有效容量、机械确认 |
| CR0402-JW-105GLF | C2076443，0 | C93949（940700） | B；需 EN_HV/I2C 时序确认 |
| RC0402FR-0711K5L | C295874，0 | C843890（10000） | B；需 VSET 复核 |
| RC0402JR-0722RL | C93929，0 | C2076445（3200） | B；需晶振起振/EMI 确认 |
| RC0603FR-07806RL | C246010，0 | C861567（6700） | B；薄膜噪声/寄生需确认 |
| L0603B100KDWFT | 精确未命中 | C2885960（1590）等 | C；DCR/容差不等，不得直接换 |
| NN03-320 | 无精确商品 | 无批准候选 | C；需 RF 重新匹配/VNA |
| XC8102AA01MR-G | C5356974，0 | C891231（5） | C；封装/引脚/电压/输出放电不同 |

## 来源

- 用户输入（路径已脱敏）：`<private-wechat-export>/BOM_12364560A_Y19.xls`（SHA-256 9B01848A704A26B94B5CAF9D5D1C3A31F3DEB31F2024FAE93E65C2423C8DC45）；`<private-wechat-export>/BOM_12364560A_Y20.xls`（SHA-256 690BBBB031D8115EE52DF3C1A473F2D91F85AFA30862DBD20DC7BB3834EE836F）。
- 官方生产 BOM/CPL、完整 BOM、Fabrication-ready 坐标、原理图和 PCB 路径均已写入交付 XLSX 的“来源与验证”页。
- 立创页面库存是 2026-08-23 查询时的动态值，厂家下单前必须再次确认库存、批次、交期和 datasheet 版本。
