thuer-awesome/wulpus/analysis/design-reference/wulpus_original_reference/BOM_JLCPCB_original.csv

Designator | Comment | Footprint | Quantity | Manufacturer | Manufacturer Part Number
C1 | 06036D475KAT2A | FP-0603-L_1_6_0_15-W_0_81-MFG | 1 |  | 06036D475KAT2A
C2 | C0402C479C5GACTU | FP-C0402-BB-MFG | 1 | Kemet | C0402C479C5GACTU
C3,C4 | GRM188R61H225KE11D | FP-GRM188-0_2-IPC_C | 2 |  | GRM188R61H225KE11D
C5 | C0603C104M5RACTU | FP-C0603C-CF-MFG | 1 | KEMET | C0603C104M5RACTU
C6 | GMK316BJ105KLHT | FP-1206-L_3_2_0_15-W_1_6-IPC_B | 1 |  | GMK316BJ105KLHT
C7,C8 | GRM188R60J106ME47D | FP-GRM188-0_1-e0_2_0_55-IPC_A | 2 |  | GRM188R60J106ME47D
C12,C14,C18,C21 | C1608X5R1H105K080AB | CAPC1608X90X20LL10 | 4 | TDK | C1608X5R1H105K080AB
C13,C15,C19,C22 | CC0603KRX7R9BB104 | FP-CC0603-DA-MFG | 4 | YAGEO | CC0603KRX7R9BB104
C17 | CL05B103KB5NNNC | FP-CL165-IPC_C | 1 |  | CL05B103KB5NNNC
D1 | ZHCS400QTA | DIODE_SOD323_DIO | 1 | Diodes | ZHCS400QTA
FB1 | BLM18PG300SH1D | FP-BLM18-0_15-t0_8-IPC_A | 1 |  | BLM18PG300SH1D
J1 | LSHM-120-02.5-L-DV-A-N-K-TR | SAMTEC_LSHM-120-XX.X-X-DV-A-N-XX | 1 | Samtec | LSHM-120-02.5-L-DV-A-N-K-TR
J2 | DF52-16S-0.8H(21) | CONN_DF52-16S-0.8H(21)_HIR | 1 |  | DF52-16S-0.8H(21)
L1 | B82422A1103K100 | TDK-B82422A1103K100_V | 1 | EPCOS-(TDK) | B82422A1103K100
L2 | NR3012T4R7M | FP-NR3012-MFG | 1 |  | NR3012T4R7M
R1,R4,R6,R8 | CSR0402FK1R00 | FP-CSR0402-MFG | 4 |  | CSR0402FK1R00
R2,R3,R19 | ERJ-2GEJ101X | RESC1005X40X25NL05T05 | 3 | Panasonic | ERJ-2GEJ101X
R5 | RC0402FR-072ML | RESC1005X40X25NL05T10 | 1 | Yageo / Phycomp | RC0402FR-072ML
R7 | ERJ-2RKF1783X | RESC1005X40X25ML05T05 | 1 | Panasonic | ERJ-2RKF1783X
R10,R11,R12,R13,R14,R15,R16,R17,R18,R21 | RC0402JR-070RL | RESC1005X40X25NL05T10 | 10 | Yageo / Phycomp | RC0402JR-070RL
U1 | LT1945IMS#PBF | LT-MS-10_L | 1 | Linear Technology | LT1945IMS#PBF
U2 | TPS61222DCKR | DCK0006A_L | 1 | Texas Instruments | TPS61222DCKR
U3,U6 | MCP1416T-E/OT | SOT-23-OT5_M | 2 |  | MCP1416T-E/OT
U4 | HV2707T-C/R8X | LQFP48_7X7MC_MCH | 1 | Microchip | HV2707T-C/R8X
U5 | MD0101K6-G | DFN18_5X5_MCH | 1 |  | MD0101K6-G
