thuer-awesome/wulpus/docs/manufacturing/missing-components/BOM_missing_parts_factory_20260823.csv

板号 | 板名 | 用户XLS源行 | 位号 | 数量 | 官方MPN | 制造商 | 官方封装 | 面别 | X_mm | Y_mm | 旋转_deg | 官方功能/网络 | 官方BOM/CPL/焊盘 | 当前DNP | LCSC精确C号 | LCSC库存 | LCSC状态 | LCSC页面 | 官方参数摘要 | 候选替代料 | 候选参数/库存 | 决策等级 | 厂家动作 | 证据来源
Y19 | HV | 27 | U4 | 1 | HV2707T-C/R8X | Microchip | LQFP48_7X7MC_MCH | Top | 8 | 13 | 270 | 16 通道 200V 高压 T/R 模拟开关；HV 收发核心与 SW_TR、RX、控制总线相连 | 存在于当前官方 BOM/CPL/PCB 焊盘 | 否 | C3656525 | 0 | 精确料号 0 In Stock | https://www.lcsc.com/product-detail/C3656525.html | Microchip；LQFP-48(7x7)；4.5–6.3V；16/14Ω级高压模拟开关 | 无批准替代；禁止 HV2708 或普通模拟开关 | 会改变高压开关拓扑、耐压或引脚功能 | C | 按官方料号询货/备料；不得替换；贴后做 HV 收发时序与通道导通验证 | E:/电子框图/wulpus/wulpus/wulpus_reproduction_package/01_pcb/jlcpcb_order_packages/02_hv_pcb/02_PCBA_BOM_CPL/BOM_JLCPCB.csv; E:/电子框图/wulpus/wulpus/wulpus_reproduction_package/01_pcb/jlcpcb_order_packages/02_hv_pcb/02_PCBA_BOM_CPL/CPL_JLCPCB.csv; E:/电子框图/wulpus/wulpus/source_current/hw/wulpus_hv_pcb/docs/fabrication_files/Pick Place/Pick Place for PCB1(Fabrication_ready).txt; E:/电子框图/wulpus/wulpus/source_current/hw/wulpus_hv_pcb/docs/wulpus_hv_mux_schematics.PDF
Y19 | HV | 28 | C12 | 1 | C1608X5R1H105K080AB | TDK | CAPC1608X90X20LL10 | Bottom | 11.75 | 16.65 | 270 | VCC_HV–USS_GND 高压轨局部去耦 | 存在于当前官方 BOM/CPL/PCB 焊盘 | 否 | 未检索到精确 C 号 | 0 | 精确料号未命中；TDK M 变体 C3875582 为 0 In Stock、±20%，不可视为等料 | https://www.lcsc.com/search?q=C1608X5R1H105K080AB | 官方：1uF ±10% 50V X5R 0603 | C342988 / C77386 | C342988 TDK 1uF ±10% 50V X5R 0603，2760；C77386 Murata 同名义参数，59880；均需核对 DC-bias、厚度和焊盘 | B | 优先原型号；替代需工程确认有效容量、耐压、DC-bias、厚度与焊盘 | E:/电子框图/wulpus/wulpus/wulpus_reproduction_package/01_pcb/jlcpcb_order_packages/02_hv_pcb/02_PCBA_BOM_CPL/BOM_JLCPCB.csv; E:/电子框图/wulpus/wulpus/wulpus_reproduction_package/01_pcb/jlcpcb_order_packages/02_hv_pcb/02_PCBA_BOM_CPL/CPL_JLCPCB.csv; E:/电子框图/wulpus/wulpus/source_current/hw/wulpus_hv_pcb/docs/fabrication_files/Pick Place/Pick Place for PCB1(Fabrication_ready).txt; E:/电子框图/wulpus/wulpus/source_current/hw/wulpus_hv_pcb/docs/wulpus_hv_mux_schematics.PDF
Y19 | HV | 28 | C14 | 1 | C1608X5R1H105K080AB | TDK | CAPC1608X90X20LL10 | Top | 0.875 | 15.5 | 270 | VCC_SW–DIG_GND 局部去耦 | 存在于当前官方 BOM/CPL/PCB 焊盘 | 否 | 未检索到精确 C 号 | 0 | 精确料号未命中；TDK M 变体 C3875582 为 0 In Stock、±20%，不可视为等料 | https://www.lcsc.com/search?q=C1608X5R1H105K080AB | 官方：1uF ±10% 50V X5R 0603 | C342988 / C77386 | 同 C12；候选库存分别 2760 / 59880 | B | 优先原型号；替代需工程确认有效容量、耐压、DC-bias、厚度与焊盘 | E:/电子框图/wulpus/wulpus/wulpus_reproduction_package/01_pcb/jlcpcb_order_packages/02_hv_pcb/02_PCBA_BOM_CPL/BOM_JLCPCB.csv; E:/电子框图/wulpus/wulpus/wulpus_reproduction_package/01_pcb/jlcpcb_order_packages/02_hv_pcb/02_PCBA_BOM_CPL/CPL_JLCPCB.csv; E:/电子框图/wulpus/wulpus/source_current/hw/wulpus_hv_pcb/docs/fabrication_files/Pick Place/Pick Place for PCB1(Fabrication_ready).txt; E:/电子框图/wulpus/wulpus/source_current/hw/wulpus_hv_pcb/docs/wulpus_hv_mux_schematics.PDF
Y19 | HV | 28 | C18 | 1 | C1608X5R1H105K080AB | TDK | CAPC1608X90X20LL10 | Top | 0.875 | 11.275 | 90 | VSYS_MCU–DIG_GND 局部去耦 | 存在于当前官方 BOM/CPL/PCB 焊盘 | 否 | 未检索到精确 C 号 | 0 | 精确料号未命中；TDK M 变体 C3875582 为 0 In Stock、±20%，不可视为等料 | https://www.lcsc.com/search?q=C1608X5R1H105K080AB | 官方：1uF ±10% 50V X5R 0603 | C342988 / C77386 | 同 C12；候选库存分别 2760 / 59880 | B | 优先原型号；替代需工程确认有效容量、耐压、DC-bias、厚度与焊盘 | E:/电子框图/wulpus/wulpus/wulpus_reproduction_package/01_pcb/jlcpcb_order_packages/02_hv_pcb/02_PCBA_BOM_CPL/BOM_JLCPCB.csv; E:/电子框图/wulpus/wulpus/wulpus_reproduction_package/01_pcb/jlcpcb_order_packages/02_hv_pcb/02_PCBA_BOM_CPL/CPL_JLCPCB.csv; E:/电子框图/wulpus/wulpus/source_current/hw/wulpus_hv_pcb/docs/fabrication_files/Pick Place/Pick Place for PCB1(Fabrication_ready).txt; E:/电子框图/wulpus/wulpus/source_current/hw/wulpus_hv_pcb/docs/wulpus_hv_mux_schematics.PDF
Y19 | HV | 28 | C21 | 1 | C1608X5R1H105K080AB | TDK | CAPC1608X90X20LL10 | Bottom | 11.9 | 10.475 | 270 | VCC_HV–USS_GND 高压轨局部去耦 | 存在于当前官方 BOM/CPL/PCB 焊盘 | 否 | 未检索到精确 C 号 | 0 | 精确料号未命中；TDK M 变体 C3875582 为 0 In Stock、±20%，不可视为等料 | https://www.lcsc.com/search?q=C1608X5R1H105K080AB | 官方：1uF ±10% 50V X5R 0603 | C342988 / C77386 | 同 C12；候选库存分别 2760 / 59880 | B | 优先原型号；替代需工程确认有效容量、耐压、DC-bias、厚度与焊盘 | E:/电子框图/wulpus/wulpus/wulpus_reproduction_package/01_pcb/jlcpcb_order_packages/02_hv_pcb/02_PCBA_BOM_CPL/BOM_JLCPCB.csv; E:/电子框图/wulpus/wulpus/wulpus_reproduction_package/01_pcb/jlcpcb_order_packages/02_hv_pcb/02_PCBA_BOM_CPL/CPL_JLCPCB.csv; E:/电子框图/wulpus/wulpus/source_current/hw/wulpus_hv_pcb/docs/fabrication_files/Pick Place/Pick Place for PCB1(Fabrication_ready).txt; E:/电子框图/wulpus/wulpus/source_current/hw/wulpus_hv_pcb/docs/wulpus_hv_mux_schematics.PDF
Y19 | HV | 29 | R7 | 1 | ERJ-2RKF1783X | Panasonic | RESC1005X40X25ML05T05 | Bottom | 8.85 | 5.7 | 270 | LT1945 高压升压反馈 178kΩ；决定 15V/HV 输出设定 | 存在于当前官方 BOM/CPL/PCB 焊盘 | 否 | C3025696 | 0 | 精确料号 0 In Stock | https://www.lcsc.com/product-detail/C3025696.html | Panasonic；178kΩ ±1%；0402；100mW；50V | C185459 | Yageo RC0402FR-07178KL，11800；178kΩ ±1%、0402、50V，但额定功率 62.5mW 低于官方页面 100mW，需核算反馈功耗 | B | 优先原型号；替代必须由工程按反馈功耗和环路误差确认 | E:/电子框图/wulpus/wulpus/wulpus_reproduction_package/01_pcb/jlcpcb_order_packages/02_hv_pcb/02_PCBA_BOM_CPL/BOM_JLCPCB.csv; E:/电子框图/wulpus/wulpus/wulpus_reproduction_package/01_pcb/jlcpcb_order_packages/02_hv_pcb/02_PCBA_BOM_CPL/CPL_JLCPCB.csv; E:/电子框图/wulpus/wulpus/source_current/hw/wulpus_hv_pcb/docs/fabrication_files/Pick Place/Pick Place for PCB1(Fabrication_ready).txt; E:/电子框图/wulpus/wulpus/source_current/hw/wulpus_hv_pcb/docs/wulpus_hv_mux_schematics.PDF
Y19 | HV | 30 | L2 | 1 | NR3012T4R7M |  | FP-NR3012-MFG | Bottom | 14.15 | 10.1 | 0 | TPS61222 5V 升压电感；官方 P&P 为 4.7uH ±20%、0.77A、0.13Ω | 存在于当前官方 BOM/CPL/PCB 焊盘 | 否 | 未检索到精确 C 号 | 0 | 精确料号未命中 | https://www.lcsc.com/search?q=NR3012T4R7M | 官方 P&P：4.7uH ±20%，约 0.77A，约 0.13Ω，3x3mm | C6364788 / C42427987 | C6364788 库存 610，1.3A/1A；C42427987 库存 470，0.9A、120mΩ；都需核对饱和/温升电流、DCR、焊盘与稳定性 | B | 优先原型号；替代需工程确认 TPS61222 稳定性、峰值电流、温升和焊盘 | E:/电子框图/wulpus/wulpus/wulpus_reproduction_package/01_pcb/jlcpcb_order_packages/02_hv_pcb/02_PCBA_BOM_CPL/BOM_JLCPCB.csv; E:/电子框图/wulpus/wulpus/wulpus_reproduction_package/01_pcb/jlcpcb_order_packages/02_hv_pcb/02_PCBA_BOM_CPL/CPL_JLCPCB.csv; E:/电子框图/wulpus/wulpus/source_current/hw/wulpus_hv_pcb/docs/fabrication_files/Pick Place/Pick Place for PCB1(Fabrication_ready).txt; E:/电子框图/wulpus/wulpus/source_current/hw/wulpus_hv_pcb/docs/wulpus_hv_mux_schematics.PDF
Y20 | Acquisition | 56 | J3 | 1 | LSHM-120-02.5-L-DV-A-N-K-TR | Samtec | SAMTEC_LSHM-120-XX.X-X-DV-A-N-XX | Top | 37.75 | 21.35 | 180 | AFE 40-pin 板间连接器；承载开关控制、电源、通道与 RX 信号 | 存在于当前官方 BOM/CPL/PCB 焊盘 | 否 | C6287797 | 101 | 精确料号 101 In Stock | https://www.lcsc.com/product-detail/C6287797.html | Samtec；40 position；0.5mm pitch；2-row vertical SMD；2A；-55–125°C | 无；按精确料号采购 | 精确型号与官方 40P/0.5mm/SMD 垂直连接器一致 | A | 可直接按官方料号补贴；保持 Top、X/Y、Rotation；贴后检查共面度和配对 | E:/电子框图/wulpus/wulpus/wulpus_reproduction_package/01_pcb/jlcpcb_order_packages/01_acquisition_pcb/02_PCBA_BOM_CPL/BOM_JLCPCB.csv; E:/电子框图/wulpus/wulpus/wulpus_reproduction_package/01_pcb/jlcpcb_order_packages/01_acquisition_pcb/02_PCBA_BOM_CPL/CPL_JLCPCB.csv; E:/电子框图/wulpus/wulpus/source_current/hw/wulpus_acquisition_pcb/docs/fabrication_files/Pick Place/Pick Place for PCB1(Fabrication_ready).txt; E:/电子框图/wulpus/wulpus/source_current/hw/wulpus_acquisition_pcb/docs/wulpus_acq_pcb_schematics.PDF
Y20 | Acquisition | 56 | J4 | 1 | LSHM-120-02.5-L-DV-A-N-K-TR | Samtec | SAMTEC_LSHM-120-XX.X-X-DV-A-N-XX | Top | 18.35 | 3.05 | 180 | MR_WOLF 40-pin 板间连接器；承载 SPI/JTAG/I2C/复位/中断与电源 | 存在于当前官方 BOM/CPL/PCB 焊盘 | 否 | C6287797 | 101 | 精确料号 101 In Stock | https://www.lcsc.com/product-detail/C6287797.html | Samtec；40 position；0.5mm pitch；2-row vertical SMD；2A；-55–125°C | 无；按精确料号采购 | 精确型号与官方 40P/0.5mm/SMD 垂直连接器一致 | A | 可直接按官方料号补贴；保持 Top、X/Y、Rotation；贴后检查共面度和配对 | E:/电子框图/wulpus/wulpus/wulpus_reproduction_package/01_pcb/jlcpcb_order_packages/01_acquisition_pcb/02_PCBA_BOM_CPL/BOM_JLCPCB.csv; E:/电子框图/wulpus/wulpus/wulpus_reproduction_package/01_pcb/jlcpcb_order_packages/01_acquisition_pcb/02_PCBA_BOM_CPL/CPL_JLCPCB.csv; E:/电子框图/wulpus/wulpus/source_current/hw/wulpus_acquisition_pcb/docs/fabrication_files/Pick Place/Pick Place for PCB1(Fabrication_ready).txt; E:/电子框图/wulpus/wulpus/source_current/hw/wulpus_acquisition_pcb/docs/wulpus_acq_pcb_schematics.PDF
Y20 | Acquisition | 57 | L3 | 1 | L0603B100KDWFT | KEMET | L0603B100KDWFT | Bottom | 17.725 | 16.26 | 90 | nRF52832 DCC/DEC4 电感；官方 P&P 为 10uH ±10%、0.38A、0.36Ω DCR | 存在于当前官方 BOM/CPL/PCB 焊盘 | 否 | 未检索到精确 C 号 | 0 | 精确料号未命中 | https://www.lcsc.com/search?q=L0603B100KDWFT | 官方 P&P：10uH ±10%；0.38A；0.36Ω DCR；0603 | 无已核实等参数现货；C2885960 仅作拒绝记录 | C3224788（±20%，停产无货）；C2885960（库存1590，但 DCR 1Ω、±20%，不等效） | C | 不得直接替换；按原 KEMET 料号询货，或由电源/RF 工程验证后再改 BOM | E:/电子框图/wulpus/wulpus/wulpus_reproduction_package/01_pcb/jlcpcb_order_packages/01_acquisition_pcb/02_PCBA_BOM_CPL/BOM_JLCPCB.csv; E:/电子框图/wulpus/wulpus/wulpus_reproduction_package/01_pcb/jlcpcb_order_packages/01_acquisition_pcb/02_PCBA_BOM_CPL/CPL_JLCPCB.csv; E:/电子框图/wulpus/wulpus/source_current/hw/wulpus_acquisition_pcb/docs/fabrication_files/Pick Place/Pick Place for PCB1(Fabrication_ready).txt; E:/电子框图/wulpus/wulpus/source_current/hw/wulpus_acquisition_pcb/docs/wulpus_acq_pcb_schematics.PDF
Y20 | Acquisition | 58 | C1 | 1 | C1608X5R1A106K080AC | TDK | FP-C1608-080-MFG | Top | 23.675 | 20.725 | 90 | 3V3 稳压输出 bulk 去耦；官方 P&P 10uF 10V X5R 0603 | 存在于当前官方 BOM/CPL/PCB 焊盘 | 否 | C2167467 | 0 | 精确料号 0 In Stock / Not available now | https://www.lcsc.com/product-detail/C2167467.html | TDK；10uF ±10%；10V；X5R；0603 | C19702 / C77044 | C19702 库存 6105160；C77044 库存 199990；均 10uF ±10% 10V X5R 0603，需核对 DC-bias、厚度和 ESL | B | 优先原型号；替代需工程确认有效容量和机械高度 | E:/电子框图/wulpus/wulpus/wulpus_reproduction_package/01_pcb/jlcpcb_order_packages/01_acquisition_pcb/02_PCBA_BOM_CPL/BOM_JLCPCB.csv; E:/电子框图/wulpus/wulpus/wulpus_reproduction_package/01_pcb/jlcpcb_order_packages/01_acquisition_pcb/02_PCBA_BOM_CPL/CPL_JLCPCB.csv; E:/电子框图/wulpus/wulpus/source_current/hw/wulpus_acquisition_pcb/docs/fabrication_files/Pick Place/Pick Place for PCB1(Fabrication_ready).txt; E:/电子框图/wulpus/wulpus/source_current/hw/wulpus_acquisition_pcb/docs/wulpus_acq_pcb_schematics.PDF
Y20 | Acquisition | 58 | C4 | 1 | C1608X5R1A106K080AC | TDK | FP-C1608-080-MFG | Top | 15.95 | 15.75 | 0 | MCU buck 输出 bulk 去耦 | 存在于当前官方 BOM/CPL/PCB 焊盘 | 否 | C2167467 | 0 | 精确料号 0 In Stock / Not available now | https://www.lcsc.com/product-detail/C2167467.html | TDK；10uF ±10%；10V；X5R；0603 | C19702 / C77044 | 同 C1；候选库存分别 6105160 / 199990 | B | 优先原型号；替代需工程确认有效容量和机械高度 | E:/电子框图/wulpus/wulpus/wulpus_reproduction_package/01_pcb/jlcpcb_order_packages/01_acquisition_pcb/02_PCBA_BOM_CPL/BOM_JLCPCB.csv; E:/电子框图/wulpus/wulpus/wulpus_reproduction_package/01_pcb/jlcpcb_order_packages/01_acquisition_pcb/02_PCBA_BOM_CPL/CPL_JLCPCB.csv; E:/电子框图/wulpus/wulpus/source_current/hw/wulpus_acquisition_pcb/docs/fabrication_files/Pick Place/Pick Place for PCB1(Fabrication_ready).txt; E:/电子框图/wulpus/wulpus/source_current/hw/wulpus_acquisition_pcb/docs/wulpus_acq_pcb_schematics.PDF
Y20 | Acquisition | 58 | C8 | 1 | C1608X5R1A106K080AC | TDK | FP-C1608-080-MFG | Bottom | 8 | 20.025 | 270 | VBAT 输入 bulk 去耦 | 存在于当前官方 BOM/CPL/PCB 焊盘 | 否 | C2167467 | 0 | 精确料号 0 In Stock / Not available now | https://www.lcsc.com/product-detail/C2167467.html | TDK；10uF ±10%；10V；X5R；0603 | C19702 / C77044 | 同 C1；候选库存分别 6105160 / 199990 | B | 优先原型号；替代需工程确认有效容量和机械高度 | E:/电子框图/wulpus/wulpus/wulpus_reproduction_package/01_pcb/jlcpcb_order_packages/01_acquisition_pcb/02_PCBA_BOM_CPL/BOM_JLCPCB.csv; E:/电子框图/wulpus/wulpus/wulpus_reproduction_package/01_pcb/jlcpcb_order_packages/01_acquisition_pcb/02_PCBA_BOM_CPL/CPL_JLCPCB.csv; E:/电子框图/wulpus/wulpus/source_current/hw/wulpus_acquisition_pcb/docs/fabrication_files/Pick Place/Pick Place for PCB1(Fabrication_ready).txt; E:/电子框图/wulpus/wulpus/source_current/hw/wulpus_acquisition_pcb/docs/wulpus_acq_pcb_schematics.PDF
Y20 | Acquisition | 58 | C9 | 1 | C1608X5R1A106K080AC | TDK | FP-C1608-080-MFG | Bottom | 3.175 | 23.225 | 180 | VUSB 输入 bulk 去耦 | 存在于当前官方 BOM/CPL/PCB 焊盘 | 否 | C2167467 | 0 | 精确料号 0 In Stock / Not available now | https://www.lcsc.com/product-detail/C2167467.html | TDK；10uF ±10%；10V；X5R；0603 | C19702 / C77044 | 同 C1；候选库存分别 6105160 / 199990 | B | 优先原型号；替代需工程确认有效容量和机械高度 | E:/电子框图/wulpus/wulpus/wulpus_reproduction_package/01_pcb/jlcpcb_order_packages/01_acquisition_pcb/02_PCBA_BOM_CPL/BOM_JLCPCB.csv; E:/电子框图/wulpus/wulpus/wulpus_reproduction_package/01_pcb/jlcpcb_order_packages/01_acquisition_pcb/02_PCBA_BOM_CPL/CPL_JLCPCB.csv; E:/电子框图/wulpus/wulpus/source_current/hw/wulpus_acquisition_pcb/docs/fabrication_files/Pick Place/Pick Place for PCB1(Fabrication_ready).txt; E:/电子框图/wulpus/wulpus/source_current/hw/wulpus_acquisition_pcb/docs/wulpus_acq_pcb_schematics.PDF
Y20 | Acquisition | 58 | C50 | 1 | C1608X5R1A106K080AC | TDK | FP-C1608-080-MFG | Top | 12.025 | 10.55 | 0 | IMU 电源 bulk 去耦 | 存在于当前官方 BOM/CPL/PCB 焊盘 | 否 | C2167467 | 0 | 精确料号 0 In Stock / Not available now | https://www.lcsc.com/product-detail/C2167467.html | TDK；10uF ±10%；10V；X5R；0603 | C19702 / C77044 | 同 C1；候选库存分别 6105160 / 199990 | B | 优先原型号；替代需工程确认有效容量和机械高度 | E:/电子框图/wulpus/wulpus/wulpus_reproduction_package/01_pcb/jlcpcb_order_packages/01_acquisition_pcb/02_PCBA_BOM_CPL/BOM_JLCPCB.csv; E:/电子框图/wulpus/wulpus/wulpus_reproduction_package/01_pcb/jlcpcb_order_packages/01_acquisition_pcb/02_PCBA_BOM_CPL/CPL_JLCPCB.csv; E:/电子框图/wulpus/wulpus/source_current/hw/wulpus_acquisition_pcb/docs/fabrication_files/Pick Place/Pick Place for PCB1(Fabrication_ready).txt; E:/电子框图/wulpus/wulpus/source_current/hw/wulpus_acquisition_pcb/docs/wulpus_acq_pcb_schematics.PDF
Y20 | Acquisition | 59 | C39 | 1 | C1608X5R1A106K080AC | TDK | CAPC0603(1608)100_L | Top | 30.25 | 8.975 | 0 | MSP430/ RX 放大器电源 bulk 去耦；1mm 厚度变体 | 存在于当前官方 BOM/CPL/PCB 焊盘 | 否 | C2167467 | 0 | 精确料号 0 In Stock / Not available now | https://www.lcsc.com/product-detail/C2167467.html | TDK；10uF ±10%；10V；X5R；0603 | C19702 / C77044 | 同名义电气参数，但 C39 官方封装为 CAPC0603(1608)100_L，必须单独核对厚度/焊盘 | B | 优先原型号；替代必须额外确认 C39 的 1mm 高度和焊盘 | E:/电子框图/wulpus/wulpus/wulpus_reproduction_package/01_pcb/jlcpcb_order_packages/01_acquisition_pcb/02_PCBA_BOM_CPL/BOM_JLCPCB.csv; E:/电子框图/wulpus/wulpus/wulpus_reproduction_package/01_pcb/jlcpcb_order_packages/01_acquisition_pcb/02_PCBA_BOM_CPL/CPL_JLCPCB.csv; E:/电子框图/wulpus/wulpus/source_current/hw/wulpus_acquisition_pcb/docs/fabrication_files/Pick Place/Pick Place for PCB1(Fabrication_ready).txt; E:/电子框图/wulpus/wulpus/source_current/hw/wulpus_acquisition_pcb/docs/wulpus_acq_pcb_schematics.PDF
Y20 | Acquisition | 60 | R2 | 1 | CR0402-JW-105GLF | BOURNS | FP-CR0402-MFG | Top | 20 | 23.3 | 180 | EN_HV 1MΩ 弱下拉；当前版本必须安装，避免 TLV62569 默认禁用 | 存在于当前官方 BOM/CPL/PCB 焊盘 | 否 | C2076443 | 0 | 精确料号 0 In Stock | https://www.lcsc.com/product-detail/C2076443.html | Bourns；1MΩ ±5%；0402；62.5mW；50V | C93949 | Yageo RC0402JR-071ML，库存 940700；1MΩ ±5%、0402、62.5mW、50V | B | 优先原型号；替代需确认 EN_HV 上电默认状态和阻值容差 | E:/电子框图/wulpus/wulpus/wulpus_reproduction_package/01_pcb/jlcpcb_order_packages/01_acquisition_pcb/02_PCBA_BOM_CPL/BOM_JLCPCB.csv; E:/电子框图/wulpus/wulpus/wulpus_reproduction_package/01_pcb/jlcpcb_order_packages/01_acquisition_pcb/02_PCBA_BOM_CPL/CPL_JLCPCB.csv; E:/电子框图/wulpus/wulpus/source_current/hw/wulpus_acquisition_pcb/docs/fabrication_files/Pick Place/Pick Place for PCB1(Fabrication_ready).txt; E:/电子框图/wulpus/wulpus/source_current/hw/wulpus_acquisition_pcb/docs/wulpus_acq_pcb_schematics.PDF
Y20 | Acquisition | 60 | R19 | 1 | CR0402-JW-105GLF | BOURNS | FP-CR0402-MFG | Top | 4.7875 | 14 | 0 | I2C SDA 上拉 1MΩ | 存在于当前官方 BOM/CPL/PCB 焊盘 | 否 | C2076443 | 0 | 精确料号 0 In Stock | https://www.lcsc.com/product-detail/C2076443.html | Bourns；1MΩ ±5%；0402；62.5mW；50V | C93949 | 同 R2；库存 940700 | B | 优先原型号；替代需确认 I2C 上拉时序和漏电预算 | E:/电子框图/wulpus/wulpus/wulpus_reproduction_package/01_pcb/jlcpcb_order_packages/01_acquisition_pcb/02_PCBA_BOM_CPL/BOM_JLCPCB.csv; E:/电子框图/wulpus/wulpus/wulpus_reproduction_package/01_pcb/jlcpcb_order_packages/01_acquisition_pcb/02_PCBA_BOM_CPL/CPL_JLCPCB.csv; E:/电子框图/wulpus/wulpus/source_current/hw/wulpus_acquisition_pcb/docs/fabrication_files/Pick Place/Pick Place for PCB1(Fabrication_ready).txt; E:/电子框图/wulpus/wulpus/source_current/hw/wulpus_acquisition_pcb/docs/wulpus_acq_pcb_schematics.PDF
Y20 | Acquisition | 60 | R20 | 1 | CR0402-JW-105GLF | BOURNS | FP-CR0402-MFG | Top | 6.8375 | 13.225 | 180 | I2C SCL 上拉 1MΩ | 存在于当前官方 BOM/CPL/PCB 焊盘 | 否 | C2076443 | 0 | 精确料号 0 In Stock | https://www.lcsc.com/product-detail/C2076443.html | Bourns；1MΩ ±5%；0402；62.5mW；50V | C93949 | 同 R2；库存 940700 | B | 优先原型号；替代需确认 I2C 上拉时序和漏电预算 | E:/电子框图/wulpus/wulpus/wulpus_reproduction_package/01_pcb/jlcpcb_order_packages/01_acquisition_pcb/02_PCBA_BOM_CPL/BOM_JLCPCB.csv; E:/电子框图/wulpus/wulpus/wulpus_reproduction_package/01_pcb/jlcpcb_order_packages/01_acquisition_pcb/02_PCBA_BOM_CPL/CPL_JLCPCB.csv; E:/电子框图/wulpus/wulpus/source_current/hw/wulpus_acquisition_pcb/docs/fabrication_files/Pick Place/Pick Place for PCB1(Fabrication_ready).txt; E:/电子框图/wulpus/wulpus/source_current/hw/wulpus_acquisition_pcb/docs/wulpus_acq_pcb_schematics.PDF
Y20 | Acquisition | 61 | R14 | 1 | RC0402FR-0711K5L | Yageo / Phycomp | RESC1005X40X25ML05T10 | Bottom | 15.675 | 21.35 | 90 | TPS62840 VSET 11.5kΩ；决定电源输出配置 | 存在于当前官方 BOM/CPL/PCB 焊盘 | 否 | C295874 | 0 | 精确料号 0 In Stock | https://www.lcsc.com/product-detail/C295874.html | Yageo；11.5kΩ ±1%；0402；62.5mW；50V | C843890 | Vishay CRCW040211K5FKED，库存 10000；11.5kΩ ±1%、0402、62.5mW；需核对额定电压/封装 | B | 优先原型号；替代需重新核算 VSET 输出和阻值容差 | E:/电子框图/wulpus/wulpus/wulpus_reproduction_package/01_pcb/jlcpcb_order_packages/01_acquisition_pcb/02_PCBA_BOM_CPL/BOM_JLCPCB.csv; E:/电子框图/wulpus/wulpus/wulpus_reproduction_package/01_pcb/jlcpcb_order_packages/01_acquisition_pcb/02_PCBA_BOM_CPL/CPL_JLCPCB.csv; E:/电子框图/wulpus/wulpus/source_current/hw/wulpus_acquisition_pcb/docs/fabrication_files/Pick Place/Pick Place for PCB1(Fabrication_ready).txt; E:/电子框图/wulpus/wulpus/source_current/hw/wulpus_acquisition_pcb/docs/wulpus_acq_pcb_schematics.PDF
Y20 | Acquisition | 62 | R26 | 1 | RC0402JR-0722RL | Yageo / Phycomp | RESC1005X40X25NL05T10 | Bottom | 30.5 | 6.425 | 0 | MSP430 8MHz 晶振串联阻尼 22Ω | 存在于当前官方 BOM/CPL/PCB 焊盘 | 否 | C93929 | 0 | 精确料号 0 In Stock | https://www.lcsc.com/product-detail/C93929.html | Yageo；22Ω ±5%；0402；62.5mW；50V | C2076445 | Bourns CR0402-JW-220GLF，库存 3200；22Ω ±5%、0402、62.5mW、50V | B | 优先原型号；替代需确认晶振起振、波形和 EMI | E:/电子框图/wulpus/wulpus/wulpus_reproduction_package/01_pcb/jlcpcb_order_packages/01_acquisition_pcb/02_PCBA_BOM_CPL/BOM_JLCPCB.csv; E:/电子框图/wulpus/wulpus/wulpus_reproduction_package/01_pcb/jlcpcb_order_packages/01_acquisition_pcb/02_PCBA_BOM_CPL/CPL_JLCPCB.csv; E:/电子框图/wulpus/wulpus/source_current/hw/wulpus_acquisition_pcb/docs/fabrication_files/Pick Place/Pick Place for PCB1(Fabrication_ready).txt; E:/电子框图/wulpus/wulpus/source_current/hw/wulpus_acquisition_pcb/docs/wulpus_acq_pcb_schematics.PDF
Y20 | Acquisition | 62 | R28 | 1 | RC0402JR-0722RL | Yageo / Phycomp | RESC1005X40X25NL05T10 | Bottom | 38.675 | 9.4 | 90 | USS 晶振串联阻尼 22Ω | 存在于当前官方 BOM/CPL/PCB 焊盘 | 否 | C93929 | 0 | 精确料号 0 In Stock | https://www.lcsc.com/product-detail/C93929.html | Yageo；22Ω ±5%；0402；62.5mW；50V | C2076445 | 同 R26；库存 3200 | B | 优先原型号；替代需确认晶振起振、波形和 EMI | E:/电子框图/wulpus/wulpus/wulpus_reproduction_package/01_pcb/jlcpcb_order_packages/01_acquisition_pcb/02_PCBA_BOM_CPL/BOM_JLCPCB.csv; E:/电子框图/wulpus/wulpus/wulpus_reproduction_package/01_pcb/jlcpcb_order_packages/01_acquisition_pcb/02_PCBA_BOM_CPL/CPL_JLCPCB.csv; E:/电子框图/wulpus/wulpus/source_current/hw/wulpus_acquisition_pcb/docs/fabrication_files/Pick Place/Pick Place for PCB1(Fabrication_ready).txt; E:/电子框图/wulpus/wulpus/source_current/hw/wulpus_acquisition_pcb/docs/wulpus_acq_pcb_schematics.PDF
Y20 | Acquisition | 63 | R30 | 1 | RC0603FR-07806RL | Yageo | RESC1608X55X25LL10T15 | Top | 40.025 | 7.6 | 180 | OPA836 RX 输出低通 806Ω；影响接收带宽/噪声 | 存在于当前官方 BOM/CPL/PCB 焊盘 | 否 | C246010 | 0 | 精确料号 0 In Stock | https://www.lcsc.com/product-detail/C246010.html | Yageo；806Ω ±1%；0603；100mW；75V | C861567 | Yageo RT0603BRD07806RL，库存 6700；806Ω ±0.1%、0603、100mW、75V；薄膜系列需核对噪声/寄生 | B | 优先原型号；替代需 RX 工程确认带宽、噪声和寄生 | E:/电子框图/wulpus/wulpus/wulpus_reproduction_package/01_pcb/jlcpcb_order_packages/01_acquisition_pcb/02_PCBA_BOM_CPL/BOM_JLCPCB.csv; E:/电子框图/wulpus/wulpus/wulpus_reproduction_package/01_pcb/jlcpcb_order_packages/01_acquisition_pcb/02_PCBA_BOM_CPL/CPL_JLCPCB.csv; E:/电子框图/wulpus/wulpus/source_current/hw/wulpus_acquisition_pcb/docs/fabrication_files/Pick Place/Pick Place for PCB1(Fabrication_ready).txt; E:/电子框图/wulpus/wulpus/source_current/hw/wulpus_acquisition_pcb/docs/wulpus_acq_pcb_schematics.PDF
Y20 | Acquisition | 64 | E1 | 1 | NN03-320 | Fractus Antennas | NN03-320 | Bottom | 1.8 | 3.8 | 90 | nRF52832 2.4GHz 芯片天线；与 L12/L13/R39 匹配网络和 keep-out 共同工作 | 存在于当前官方 BOM/CPL/PCB 焊盘 | 否 | 未检索到精确 C 号 | 0 | 无精确商品；泛搜索无可验证同料 | https://www.lcsc.com/search?q=NN03-320 | Ignion/Fractus 芯片天线；必须按匹配网络、keep-out、认证验证 | 无批准替代；不得用普通 1206/陶瓷天线替换 | 泛搜索出现的其他 2.4GHz 天线尺寸、谐振和认证均不同 | C | 按 NN03-320 原型号采购；若停产，必须由 RF 工程重新匹配、VNA 测试并更新认证资料 | E:/电子框图/wulpus/wulpus/wulpus_reproduction_package/01_pcb/jlcpcb_order_packages/01_acquisition_pcb/02_PCBA_BOM_CPL/BOM_JLCPCB.csv; E:/电子框图/wulpus/wulpus/wulpus_reproduction_package/01_pcb/jlcpcb_order_packages/01_acquisition_pcb/02_PCBA_BOM_CPL/CPL_JLCPCB.csv; E:/电子框图/wulpus/wulpus/source_current/hw/wulpus_acquisition_pcb/docs/fabrication_files/Pick Place/Pick Place for PCB1(Fabrication_ready).txt; E:/电子框图/wulpus/wulpus/source_current/hw/wulpus_acquisition_pcb/docs/wulpus_acq_pcb_schematics.PDF
Y20 | Acquisition | 65 | U6 | 1 | XC8102AA01MR-G | Torex | XC8102_SOT-25_TOR | Top | 33.3511 | 8.175 | 0 | RX 放大器负载开关；active-high、400mA、带输出放电 | 存在于当前官方 BOM/CPL/PCB 焊盘 | 否 | C5356974 | 0 | 精确料号 0 In Stock | https://www.lcsc.com/product-detail/C5356974.html | Torex；1ch；active-high；1.2–6V；400mA；SOT-25-5；870mΩ；输出放电 | FPF2106 / C891231 仅工程候选 | 候选库存 5，但为 SOT-23-5、1.8–5.5V、引脚/保护/输出放电功能不同且停产标记 | C | 按原型号采购；不得直接换 FPF2106；若必须替代需核对引脚、VIN、CE、放电和 RX 上电时序 | E:/电子框图/wulpus/wulpus/wulpus_reproduction_package/01_pcb/jlcpcb_order_packages/01_acquisition_pcb/02_PCBA_BOM_CPL/BOM_JLCPCB.csv; E:/电子框图/wulpus/wulpus/wulpus_reproduction_package/01_pcb/jlcpcb_order_packages/01_acquisition_pcb/02_PCBA_BOM_CPL/CPL_JLCPCB.csv; E:/电子框图/wulpus/wulpus/source_current/hw/wulpus_acquisition_pcb/docs/fabrication_files/Pick Place/Pick Place for PCB1(Fabrication_ready).txt; E:/电子框图/wulpus/wulpus/source_current/hw/wulpus_acquisition_pcb/docs/wulpus_acq_pcb_schematics.PDF
