thuer-awesome/wulpus/hardware/wulpus-pro/acquisition-dev-board/manufacturing/jlcpcb/02_PCBA_BOM_CPL/BOM_FULL_REFERENCE.csv

Designator | Source_Name | Source_MPN1 | Preferred_MPN | Description | Quantity_Per_Board | Assembly_Method | Note
C2, C17, C18, C19, C21, C22, C23, C29, C31, C33, C51, C52, C53, C73, C74, C75, C76 | C0402C104K4RACTU | GRM155R71C104KA88D | GRM155R71C104KA88D |  | 17 | SMT / 嘉立创贴片
C24, C25 | GRM1555C1H100JA01D | GRM1555C1H100JA01D | GRM1555C1H100JA01D |  | 2 | SMT / 嘉立创贴片
PJ1 | 5051100892 |  | 5051100892 |  | 1 | SMT / 嘉立创贴片 | 底面 SMT。官方 ERRATA：相对 WULPUS v1.2.2 的 MSP430 编程口引脚对称镜像，旧转接板不能直接连接。
R35, R38 | RC0402JR-0722RL | RC0402JR-0722RL | RC0402JR-0722RL |  | 2 | SMT / 嘉立创贴片
R36 | CPF0402B324RE1 | CPF0402B324RE1 | CPF0402B324RE1 |  | 1 | SMT / 嘉立创贴片
U13 | MD0100N8-G |  | MD0100N8-G |  | 1 | SMT / 嘉立创贴片
X5, X6, X7, X8 | 68000-102HLF | 68000-102HLF | 68000-102HLF | 2 Positions Header, Unshrouded Connector 0.100" (2.54mm) Through Hole Gold or Gold, GXT™ | 4 | PTH / 手焊
X1, X3, X4 | 68000-106HLF | 68000-106HLF | 68000-106HLF | 6 Positions Header, Unshrouded Connector 0.100" (2.54mm) Through Hole Gold or Gold, GXT™ | 3 | PTH / 手焊
U11 | HV2707T-C/R8X |  | HV2707T-C/R8X | 16-CH 200V No Hv Bias Switch (SPST), 2 Bleed Resistor 48 LQFP 7X7X1.4MM T/r Rohs Compliant: Yes | 1 | SMT / 嘉立创贴片
R9 | RMCF0201JT47K0 | RMCF0201JT47K0 | RMCF0201JT47K0 | 47kΩ ±5% 0.05W 0201 Thick Film Chip Resistor AEC-Q200 compliant | 1 | SMT / 嘉立创贴片
J12 | DF40HC(3.0)-50DS-0.4V(51) |  | DF40HC(3.0)-50DS-0.4V(51) | 50 Position 0.4mm Pitch Dual Row Vertical Surface Mount (SMT) Pin Socket, 3.0mm Stacking Height | 1 | SMT / 嘉立创贴片
U3 | TPL0501-100RSER | TPL0501-100RSER | TPL0501-100RSER | 256-Tap, 100 k, Single Channel Potentiometer with SPI Interface, -40 to 125 degC, 8-pin QFN (RSE8), Green (RoHS & no Sb/Br) | 1 | SMT / 嘉立创贴片
U4, U7 | TS5A3159AYZPR |  | TS5A3159AYZPR | Analogue Switch ICs SPDT ANALOG SWITCH | 2 | SMT / 嘉立创贴片
FB3, FB4 | BLM18SP101SH1D | BLM18SP101SH1D | BLM18SP101SH1D | BLM18SP101SH1D Ferrite Beads Multi-Layer 100Ohm 25% 100MHz 3.7A 0.022Ohm DCR 0603 Automotive T/R | 2 | SMT / 嘉立创贴片
FB1, FB2 | BLM18SP101SN1D | BLM18SP101SN1D | BLM18SP101SN1D | BLM18SP101SN1D Ferrite Bead, 100 Ohm, 3.7A, 0603 Rohs Compliant: Yes |Murata BLM18SP101SN1D | 2 | SMT / 嘉立创贴片
C8, C9, C11, C14, C15, C20, C28, C30, C32, C40, C48, C49, C50 | C1005X7S1A225K050BC | C1005X7S1A225K050BC | C1005X7S1A225K050BC | CAP CER 2.2UF 10V X7S 0402 | 13 | SMT / 嘉立创贴片
C64 | GCM21BR71H105KA03L | GCM21BR71H105KA03L | GCM21BR71H105KA03L | Ceramic Capacitor for Automotive 1uF ±10% 50VDC X7R 0805 Embossed T/R | 1 | SMT / 嘉立创贴片
C3, C6 | GRM033R71A103KA01D | GRM033R71A103KA01D | GRM033R71A103KA01D | Chip Multilayer Ceramic Capacitors for General Purpose, 0201, 10000pF, X7R, 15%, 10%, 10V | 2 | SMT / 嘉立创贴片
C67 | GRM155C71H104KE19D | GRM155C71H104KE19D | GRM155C71H104KE19D | Chip Multilayer Ceramic Capacitors for General Purpose, 0402, 0.10uF, X7S, 22%, 10%, 50V | 1 | SMT / 嘉立创贴片
C69, C70, C71, C72 | GRM155Z71A105KE01D | GRM155Z71A105KE01D | GRM155Z71A105KE01D | Chip Multilayer Ceramic Capacitors for General Purpose, 0402, 1.0uF, X7R, 15%, 10%, 10V | 4 | SMT / 嘉立创贴片
C4, C7, C10, C43, C45, C46, C56 | GRM1555C1H102JA01D | GRM1555C1H102JA01D | GRM1555C1H102JA01D | Chip Multilayer Ceramic Capacitors for General Purpose, 0402, 1000pF, C0G, 30ppm/°C, 5%, 50V | 7 | SMT / 嘉立创贴片
C41, C42 | GRM155R71H473ME14D | GRM155R71H473ME14D | GRM155R71H473ME14D | Chip Multilayer Ceramic Capacitors for General Purpose, 0402, 47000pF, X7R, 15%, 20%, 50V | 2 | SMT / 嘉立创贴片
C26, C34, C35, C36, C37, C38, C39, C61, C62, C63, C65, C66, C68 | GRM188R61H225ME11D | GRM188R61H225ME11D | GRM188R61H225ME11D | Chip Multilayer Ceramic Capacitors for General Purpose, 0603, 2.2uF, X5R, 15%, 20%, 50V | 13 | SMT / 嘉立创贴片
J1, J2 | DF40C-40DS-0.4V(51) | DF40C-40DS-0.4V(51) | DF40C-40DS-0.4V(51) | CONN RCPT 40POS SMD GOLD | 2 | SMT / 嘉立创贴片 | 官方料号 DF40C-40DS-0.4V(51)，1.5 mm 堆叠高度；ERRATA 建议使用更高连接器留出 HV2707 高度余量。 | 官方料号 DF40C-40DS-0.4V(51)，1.5 mm 堆叠高度；ERRATA 建议使用更高连接器留出 HV2707 高度余量。
J10, J11 | U.FL-R-SMT-1(10) | U.FL-R-SMT-1(10) | U.FL-R-SMT-1(10) | CONN U.FL RCPT STR 50 OHM SMD | 2 | SMT / 嘉立创贴片
J3, J5 | 91931-31169LF |  | 91931-31169LF | Conn; Rect; Industrial; MezzanineRECP; 69Cnts; SMT; I-IndustrialSeries | 2 | SMT / 嘉立创贴片
R4, R21, R33, R34 | CRCW04021R00FKEDC | CRCW04021R00FKEDC | CRCW04021R00FKEDC | CRCW04021R00FKEDC Res Thick Film 0402 1 Ohm 1% 1/16W ±100ppm/°C Molded SMD Paper T/R | 4 | SMT / 嘉立创贴片
X2 | FY0800018 | FY0800018 | FY0800018 | Crystal 8MHz ±30ppm (Tol) ±30ppm (Stability) 18pF FUND 100Ohm 4-Pin SMD T/R | 1 | SMT / 嘉立创贴片
Y2 | ABS05-32.768KHZ-9-T | ABS05-32.768KHZ-9-T | ABS05-32.768KHZ-9-T | CRYSTAL 32.7680KHZ 9PF SMD | 1 | SMT / 嘉立创贴片
D1 | BAV99T-7-F | BAV99T-7-F | BAV99T-7-F | DIODE ARRAY GP 85V 75MA SOT523 | 1 | SMT / 嘉立创贴片
D3 | ZHCS400QTA | ZHCS400QTA | ZHCS400QTA | Diode Schottky 40V 1A Automotive 2-Pin SOD-323 T/R | 1 | SMT / 嘉立创贴片
U15 | LT3463AEDD#PBF | LT3463AEDD#PBF | LT3463AEDD#PBF | Dual Micropower DC/DC Converters with Schottky Diodes, 2.4 to 15 V Vin, 10-pin SON (DD-10), -40 to 85 degC, Pb-Free | 1 | SMT / 嘉立创贴片
R39, R42 | ERJ-2RKF1004X |  | ERJ-2RKF1004X | 1MΩ | 2 | SMT / 嘉立创贴片
R41 | ERJ-2RKF4122X |  | ERJ-2RKF4122X | 41.2 kΩ | 1 | SMT / 嘉立创贴片
R40 | ERJ-2RKF4322X |  | ERJ-2RKF4322X | 43.2 kΩ | 1 | SMT / 嘉立创贴片
R24 | ERJ-PA3J302V |  | ERJ-PA3J302V | 3k 1/3W | 1 | SMT / 嘉立创贴片
C5 | 04025C332JAT2A | 04025C332JAT2A | 04025C332JAT2A | General Purpose Ceramic Capacitor, 0402, 3.3nF, 5%, X7R, 15%, 50V | 1 | SMT / 嘉立创贴片
C13, C27 | 04025A101FAT2A | 04025A101FAT2A | 04025A101FAT2A | General Purpose Ceramic Capacitor, 0402, 100pF, 1%, C0G, 30ppm/°C, 50V | 2 | SMT / 嘉立创贴片
C16, C44, C47 | GRM188R60J476ME01D | GRM188R60J476ME01D | GRM188R60J476ME01D | GRM188R60J476ME01D Ceramic Capacitor, Multilayer, Ceramic, 6.3V, 20% +Tol, 20% -Tol, X5R, 15% TC, 47uF, Surface Mount, 0603 | 3 | SMT / 嘉立创贴片
U1 | AD8338ACPZ-R7 | AD8338ACPZ-R7 | AD8338ACPZ-R7 | IC OPAMP VGA 1 CIRCUIT 16LFCSP | 1 | SMT / 嘉立创贴片 | ERRATA 改进建议：AD8338 OFFSN 最好接电容以增加高通滤波；官方生产文件未修改。
U5 | LTC5507ES6#TRMPBF | LTC5507ES6#TRMPBF | LTC5507ES6#TRMPBF | IC RF DETECT 100KHZ-1GHZ TSOT23 | 1 | SMT / 嘉立创贴片
U9 | IXDD604D2TR |  | IXDD604D2TR | Integrated Circuit | 1 | SMT / 嘉立创贴片
D2 | APHD1608LZGCK | APHD1608LZGCK | APHD1608LZGCK | LED GREEN CLEAR 1608 SMD | 1 | SMT / 嘉立创贴片
Q1 | NX7002BKMBYL |  | NX7002BKMBYL | MOSFET (N-Channel) | 1 | SMT / 嘉立创贴片
C1 | GJM1555C1H1R5BB01D | GJM1555C1H1R5BB01D | GJM1555C1H1R5BB01D | Multi-Layer Ceramic Capacitor 1.5pF C0G ±0.1pF 0402 Paper T/R | 1 | SMT / 嘉立创贴片
C54, C55, C57, C58, C59, C60 | GJM1555C1H120GB01D | GJM1555C1H120GB01D | GJM1555C1H120GB01D | Multi-Layer Ceramic Capacitor 12pF C0G ±2% 0402 Paper T/R | 6 | SMT / 嘉立创贴片
J4, J6 | DF52-16S-0.8H(21) |  | DF52-16S-0.8H(21) | No Description Available | 2 | SMT / 嘉立创贴片
U14 | MSP430FR5043IRGCT |  | MSP430FR5043IRGCT | No Description Available | 1 | SMT / 嘉立创贴片
Y1 | AWSCR-8.00CV-T |  | AWSCR-8.00CV-T | No Description Available | 1 | SMT / 嘉立创贴片
R15 | ERJ-3GEY0R00V | ERJ-3GEY0R00V | ERJ-3GEY0R00V | RES SMD 0 OHM JUMPER 1/10W 0603 | 1 | SMT / 嘉立创贴片
R5 | MCS04020C2701FE000 | MCS04020C2701FE000 | MCS04020C2701FE000 | RES SMD 1.2K OHM 1% 1/10W 0402 | 1 | SMT / 嘉立创贴片
R2, R3 | ERJ-2RKF2001X | ERJ-2RKF2001X | ERJ-2RKF2001X | RES SMD 2K OHM 1% 1/10W 0402 | 2 | SMT / 嘉立创贴片
R27, R28 | ERJ-2RKF1003X | ERJ-2RKF1003X | ERJ-2RKF1003X | RES SMD 100K OHM 1% 1/10W 0402 | 2 | SMT / 嘉立创贴片
R26, R29 | RC1005F394CS | RC1005F394CS | RC1005F394CS | Res Thick Film 0402 390kΩ 1% 0.063W ±100ppm/°C Molded SMD T/R | 2 | SMT / 嘉立创贴片
R8, R18, R23, R45, R47 | CRCW04020000Z0ED | CRCW04020000Z0ED | CRCW04020000Z0ED | RES Thick Film, 0Ω, 0.063W, 0402 | 5 | SMT / 嘉立创贴片 | 官方 BOM/CPL 中安装。ERRATA 给出的现版返修方案是移除 R23，并用导线把 RGND 接到 +HV；下单包未擅自改动。
R31, R32 | CRCW04021M00FKED | CRCW04021M00FKED | CRCW04021M00FKED | RES Thick Film, 1MΩ, 1%, 0.063W, 100ppm/°C, 0402 | 2 | SMT / 嘉立创贴片
R1 | CRCW04021K30JNED | CR0402-JW-132GLF | CR0402-JW-132GLF | RES Thick Film, 1.3kΩ, 5%, 0.063W, 200ppm/°C, 0402 | 1 | SMT / 嘉立创贴片
R10, R11, R12, R14, R16, R22, R43, R44 | CRCW040210K0JNED | CRCW040210K0JNED | CRCW040210K0JNED | RES Thick Film, 10kΩ, 5%, 0.063W, 200ppm/°C, 0402 | 8 | SMT / 嘉立创贴片
R37 | CRCW040247K0FKED | CRCW040247K0FKED | CRCW040247K0FKED | RES Thick Film, 47kΩ, 1%, 0.063W, 100ppm/°C, 0402 | 1 | SMT / 嘉立创贴片
R13 | CRCW040251R0JNED | CRCW040251R0JNED | CRCW040251R0JNED | RES Thick Film, 51Ω, 5%, 0.063W, 200ppm/°C, 0402 | 1 | SMT / 嘉立创贴片
L1, L2 | 742792040 | 742792040 | 742792040 | SMD EMI Suppression Ferrite Bead WE-CBF, Z = 600 Ohm | 2 | SMT / 嘉立创贴片
U6, U8, U12, U16 | TPS22916CYFPR |  | TPS22916CYFPR | TPS22916 5.5-V, 2-A Ultra-Low Leakage Load Switch | 4 | SMT / 嘉立创贴片 | 官方 ERRATA：输入端应至少有 1 uF 电容，但 v1.0.0 未放置。必须在生产前做工程评审。
U2, U10 | OPA836IDBVT |  | OPA836IDBVT | Very Low Power, Rail to Rail Out, Negative Rail In, VFB Operational Amplifier, 2.5 to 5.5 V, -40 to 125 degC, 6-pin SOT23 (DBV6), Green (RoHS & no Sb/Br) | 2 | SMT / 嘉立创贴片
U17, U18 | SN74AVC4T774RSVR |  | SN74AVC4T774RSVR | Voltage Level Translator Bidirectional 1 Circuit 4 Channel 380Mbps 16-UQFN _2.6x1.8_ | 2 | SMT / 嘉立创贴片
L3, L4 | LQH3NPZ100MMEL | LQH3NPZ100MMEL | LQH3NPZ100MMEL | Wire Wound Ferrite Inductor for Power Lines For Automotive 10μH ±20% 0.228Ω 1280mA 1212 | 2 | SMT / 嘉立创贴片
