thuer-awesome/wulpus/hardware/wulpus-pro/polycmut-adapter/manufacturing/jlcpcb/02_PCBA_BOM_CPL/BOM_JLCPCB.csv

Designator | Comment | Footprint | Quantity | Manufacturer | Manufacturer Part Number
J3,J4 | 91910-21169LF | AMPHENOL_91910-21169LF | 2 |  | 91910-21169LF
R1,R2,R3,R4,R5,R6,R7,R8 | CR0402-J/-000GLF | RESC1005X40X25NL05T10 | 8 |  | CR0402-J/-000GLF
