thuer-awesome/wulpus/hardware/wulpus-pro/polycmut-adapter/manufacturing/jlcpcb/02_PCBA_BOM_CPL/COMPONENT_CHECKLIST.csv

Designator | Preferred_MPN | Source_Name | Source_MPN1 | Description | BOM_Group_Quantity | Per_Designator_Qty | Layer | Mid_X_mm | Mid_Y_mm | Rotation_deg | Footprint | Assembly_Method | JLCPCB_Upload | Note
J3 | 91910-21169LF | 91910-21169LF |  |  | 2 | 1 | Bottom | 0.0000 | -15.0000 | 180 | AMPHENOL_91910-21169LF | SMT / 嘉立创贴片 | Yes | 底面 SMT；细间距连接器，贴片前必须核对 1 脚、面别和 DFM。
J4 | 91910-21169LF | 91910-21169LF |  |  | 2 | 1 | Bottom | 0.0000 | 15.0000 | 0 | AMPHENOL_91910-21169LF | SMT / 嘉立创贴片 | Yes | 底面 SMT；细间距连接器，贴片前必须核对 1 脚、面别和 DFM。
J5 | 901-144-8RFX | 901-144-8RFX | 901-144-8RFX | Coaxial Connector, 18 GHz, 50 Ohm, -65 to 165 degC, 5-Pin THD, RoHS, Bulk | 1 | 1 | Top | 13.7000 | 0.0000 | 0 | AMPH-901-144-8RFX_V | PTH / 手焊 | No | 通孔同轴连接器 901-144-8RFX，嘉立创 SMT BOM/CPL 已排除，PCBA 后手焊。
P1 | polycmut | polycmut |  |  | 1 | 1 | Top | 0.0000 | 0.0000 | 180 | Interposer | 外接 polyCMUT/interposer / 非嘉立创贴片 | No | polyCMUT/interposer 外部组件，不是普通嘉立创 SMT 料；嘉立创 BOM/CPL 已排除。
R1 | CR0402-J/-000GLF | RC0402JR-070RL | CR0402-J/-000GLF |  | 8 | 1 | Top | 3.0000 | -8.7500 | 180 | RESC1005X40X25NL05T10 | SMT / 嘉立创贴片 | Yes
R2 | CR0402-J/-000GLF | RC0402JR-070RL | CR0402-J/-000GLF |  | 8 | 1 | Top | 3.0000 | 8.7500 | 180 | RESC1005X40X25NL05T10 | SMT / 嘉立创贴片 | Yes
R3 | CR0402-J/-000GLF | RC0402JR-070RL | CR0402-J/-000GLF |  | 8 | 1 | Top | 1.0000 | -8.7500 | 180 | RESC1005X40X25NL05T10 | SMT / 嘉立创贴片 | Yes
R4 | CR0402-J/-000GLF | RC0402JR-070RL | CR0402-J/-000GLF |  | 8 | 1 | Top | 1.0000 | 8.7500 | 180 | RESC1005X40X25NL05T10 | SMT / 嘉立创贴片 | Yes
R5 | CR0402-J/-000GLF | RC0402JR-070RL | CR0402-J/-000GLF |  | 8 | 1 | Top | -1.0000 | -8.7500 | 180 | RESC1005X40X25NL05T10 | SMT / 嘉立创贴片 | Yes
R6 | CR0402-J/-000GLF | RC0402JR-070RL | CR0402-J/-000GLF |  | 8 | 1 | Top | -1.0000 | 8.7500 | 180 | RESC1005X40X25NL05T10 | SMT / 嘉立创贴片 | Yes
R7 | CR0402-J/-000GLF | RC0402JR-070RL | CR0402-J/-000GLF |  | 8 | 1 | Top | -3.0000 | -8.7500 | 180 | RESC1005X40X25NL05T10 | SMT / 嘉立创贴片 | Yes
R8 | CR0402-J/-000GLF | RC0402JR-070RL | CR0402-J/-000GLF |  | 8 | 1 | Top | -3.0000 | 8.7500 | 180 | RESC1005X40X25NL05T10 | SMT / 嘉立创贴片 | Yes
