thuer-awesome/wulpus/hardware/wulpus-v1/msp430-programmer/manufacturing/jlcpcb/02_Manual_Solder/BOM_JLCPCB.csv

Designator | Comment | Footprint | Quantity | Manufacturer | Manufacturer Part Number
CONN_JW1 | 5051100892 | MOLEX_5051100892 | 1 | Molex | 5051100892
