thuer-awesome/wulpus/hardware/wulpus-v1/msp430-programmer/manufacturing/jlcpcb/02_Manual_Solder/COMPONENT_CHECKLIST.csv

Designator | Manufacturer_Part_Number | BOM_Group_Quantity | Per_Designator_Qty | Manufacturer | Layer | Mid_X_mm | Mid_Y_mm | Rotation_deg | Footprint | Assembly_Method | Note
J_OLMX1 | SAMTEC-TST-110-01-X-DJ | 1 | 1 | Samtec | Top | 13.2180 | 10.9090 | 0 | HDR2X10 | PTH / 手焊 | Samtec 2x10 通孔排针，必须手焊
CONN_JW1 | 5051100892 | 1 | 1 | Molex | Top | 13.7680 | 4.1760 | 180 | MOLEX_5051100892 | SMT
