thuer-awesome/wulpus/hardware/wulpus-v1/nrf52-programmer/manufacturing/jlcpcb/02_Manual_Solder/BOM_JLCPCB.csv

Designator | Comment | Footprint | Quantity | Manufacturer | Manufacturer Part Number
CONN_SWDN1 | 5051100692 | MOLEX_5051100692 | 1 | Molex | 5051100692
