thuer-awesome/wulpus/hardware/wulpus-v1/nrf52-programmer/manufacturing/jlcpcb/02_Manual_Solder/COMPONENT_CHECKLIST.csv

Designator | Manufacturer_Part_Number | BOM_Group_Quantity | Per_Designator_Qty | Manufacturer | Layer | Mid_X_mm | Mid_Y_mm | Rotation_deg | Footprint | Assembly_Method | Note
CONN_SWDN1 | 5051100692 | 1 | 1 | Molex | Top | 13.4100 | 4.3110 | 180 | MOLEX_5051100692 | SMT
S_NRDC1 | SAMTEC-TST-110-01-X-DJ | 1 | 1 | Samtec | Top | 13.4670 | 10.5060 | 0 | HDR2X10 | PTH / 手焊 | Samtec 2x10 通孔排针，必须手焊
