thuer-awesome/wulpus/docs/manufacturing/missing-components/USER_BOM_PROVENANCE.md

# Private user BOM provenance

The two source workbooks were supplied from a private WeChat export. They are
referenced by a redacted local path and hash for auditability but are
intentionally **not copied into this public repository**. The private account
and user-directory components of the path are omitted.

| Board label | Source path (local) | Size (bytes) | SHA256 |
|---|---|---:|---|
| Y19 | `<private-wechat-export>/BOM_12364560A_Y19.xls` | 37888 | `9B01848A704A26B94B5CAF9D5D1C3A31F3DEB31F2024FAE93E65C2423C8DC45` |
| Y20 | `<private-wechat-export>/BOM_12364560A_Y20.xls` | 68608 | `690BBBB031D8115EE52DF3C1A473F2D91F85AFA30862DBD20DC7BB3834EE836F` |

The derived factory XLSX/CSV and audit Markdown in this folder contain only the
necessary component identifiers, placement data, evidence paths, and procurement
decisions. Re-run the source comparison against the same workbooks before a
future production batch.
