thuer-awesome/wulpus/hardware/wulpus-v1/acquisition-pcb/manufacturing/jlcpcb/02_PCBA_BOM_CPL/BOM_JLCPCB.csv

Designator | Comment | Footprint | Quantity | Manufacturer | Manufacturer Part Number
C1,C4,C8,C9,C50 | C1608X5R1A106K080AC | FP-C1608-080-MFG | 5 | TDK | C1608X5R1A106K080AC
C2,C3,C14 | EMK107ABJ475KA-T | FP-0603-L_1_6_0_15-W_0_8-IPC_A | 3 |  | EMK107ABJ475KA-T
C6 | C1005X5R1E474K050BB | CAPC1050X55X10LL05 | 1 | TDK | C1005X5R1E474K050BB
C7 | CC0402KRX5R5BB105 | FP-CC0402-MFG | 1 | YAGEO | CC0402KRX5R5BB105
C10,C15,C16,C27,C28,C29,C42,C49,C51 | CC0402KRX7R7BB104 | FP-CC0402-MFG | 9 | YAGEO | CC0402KRX7R7BB104
C12 | 04025A101JAT2A | FP-04025A101JAT2A-MFG | 1 |  | 04025A101JAT2A
C13,C24,C25,C26,C40,C43,C45 | C1608X7R1C105K080AC | FP-C1608-080-0_1-IPC_B | 7 |  | C1608X7R1C105K080AC
C17 | GJM1555C1HR80WB01D | FP-GJM155-0_05-IPC_A | 1 |  | GJM1555C1HR80WB01D
C18,C19,C20,C21,C32,C33,C34,C36,C37,C38,C41 | GJM1555C1H120GB01D | FP-GJM155-0_05-IPC_A | 11 |  | GJM1555C1H120GB01D
C22,C30 | C2012X5R1A336M125AC | FP-C2012-125-0_2-IPC_A | 2 |  | C2012X5R1A336M125AC
C23,C31,C35,C44 | GRM1555C1H102JA01D | FP-GRM155-0_05-IPC_B | 4 |  | GRM1555C1H102JA01D
C39 | C1608X5R1A106K080AC | CAPC0603(1608)100_L | 1 |  | C1608X5R1A106K080AC
C47,C48 | CGA3E1X5R1C225K080AC | FP-CGA3E-0_3-0_1-MFG | 2 |  | CGA3E1X5R1C225K080AC
D1,D2 | APHD1608LZGCK | FP-APHD1608LZGCK-MFG | 2 |  | APHD1608LZGCK
E1 | NN03-320 | NN03-320 | 1 | Fractus Antennas | NN03-320
FB1,FB2,FB3 | BLM03AX800SN1D | MURA-BLM03-CHIP-2_V | 3 | Murata | BLM03AX800SN1D
J1 | 629105136821 | 629105136821 | 1 | Wurth Elektronik | 629105136821
J2 | DF52-2S-0.8H(21) | DF522S08H21 | 1 |  | DF52-2S-0.8H(21)
J3,J4 | LSHM-120-02.5-L-DV-A-N-K-TR | SAMTEC_LSHM-120-XX.X-X-DV-A-N-XX | 2 | Samtec | LSHM-120-02.5-L-DV-A-N-K-TR
J5 | DF52-6S-0.8H(21) | HIROSE_DF52-6S-0.8H(21) | 1 |  | DF52-6S-0.8H(21)
L1,L2 | DFE201612E-2R2M=P2 | INDC2016X10L | 2 | Murata Electronics | DFE201612E-2R2M=P2
L3 | L0603B100KDWFT | L0603B100KDWFT | 1 | KEMET | L0603B100KDWFT
L4 | LQW15AN15NJ00D | FP-LQW15AN_00-W0_6-0_1-MFG | 1 |  | LQW15AN15NJ00D
L5 | LQG15HS3N9B02D | INDC1005X45N | 1 | Murata | LQG15HS3N9B02D
L8,L9,L10,L11 | 742792040 | SMD-0805 | 4 |  | 742792040
L12 | LQW18AN4N3G80D | FP-LQW18AN_80-MFG | 1 |  | LQW18AN4N3G80D
L13 | LQW15AN3N3G80D | FP-LQW15AN_80-MFG | 1 |  | LQW15AN3N3G80D
PJ1 | 5051100892 | MOLEX_5051100892 | 1 |  | 5051100892
R1,R5,R6,R8,R9,R10,R11,R13 | ERJ-2BWFR100X | FP-CSR0402-MFG | 8 |  | ERJ-2BWFR100X
R2,R19,R20 | CR0402-JW-105GLF | FP-CR0402-MFG | 3 |  | CR0402-JW-105GLF
R4 | RC0402FR-07453KL | RESC1005X40X25NL05T10 | 1 | Yageo | RC0402FR-07453KL
R7 | RMCF0402FT100K | RESC1005X40X25LL10T15 | 1 | Stackpole-Electronics-Inc. | RMCF0402FT100K
R12 | CRCW0402267KFKED | RESC1005X40X25LL05T05 | 1 | Vishay Dale | CRCW0402267KFKED
R14 | RC0402FR-0711K5L | RESC1005X40X25ML05T10 | 1 | Yageo / Phycomp | RC0402FR-0711K5L
R15,R34 | RC0402JR-070RL | RESC1005X40X25NL05T10 | 2 | Yageo / Phycomp | RC0402JR-070RL
R16,R17 | TNPW040210K0BEED | FP-TNPW0402-e3-MFG | 2 | Vishay | TNPW040210K0BEED
R18 | CSRF0402FT10L0 | FP-CSRF0402-high-IPC_A | 1 |  | CSRF0402FT10L0
R23,R27 | CPF0402B324RE1 | RESC1005X35X20ML05T10 | 2 | TE Connectivity / AMP | CPF0402B324RE1
R24,R25 | CRCW04021M00FKED | FP-CRCW0402-e3-MFG | 2 |  | CRCW04021M00FKED
R26,R28 | RC0402JR-0722RL | RESC1005X40X25NL05T10 | 2 | Yageo / Phycomp | RC0402JR-0722RL
R29 | CRCW040247K0FKED | FP-CRCW0402-e3-IPC_C | 1 |  | CRCW040247K0FKED
R30 | RC0603FR-07806RL | RESC1608X55X25LL10T15 | 1 | Yageo | RC0603FR-07806RL
R31 | RC0603FR-071K82L | RESC1608X55X25ML10T15 | 1 | Yageo | RC0603FR-071K82L
R35,R39 | CR0402-J/-000GLF | FP-CR0402-IPC_B | 2 |  | CR0402-J/-000GLF
R36 | RC0603FR-0724K9L | FP-RC_L0603-MFG | 1 | Yageo | RC0603FR-0724K9L
R37,R38 | RC0603FR-072ML | RESC1608X55X30LL15T15 | 2 | YAEGO | RC0603FR-072ML
SW1 | 5051100692 | MOLEX_5051100692 | 1 |  | 5051100692
U1 | TLV62569PDRLR | TLV62569PDRLR | 1 | Texas Instruments | TLV62569PDRLR
U2 | TPS62840YBGR | BGA6C40P2X3_97X147X50 | 1 | Texas Instruments | TPS62840YBGR
U3 | BQ27441DRZT-G1B | DRZ0012A_MFG | 1 | Texas Instruments | BQ27441DRZT-G1B
U4 | NRF52832-QFAA-R | NRSC-QF-48_M | 1 | Nordic Semiconductor | NRF52832-QFAA-R
U5 | MSP430FR5043IRGCT | RGC0064G | 1 |  | MSP430FR5043IRGCT
U6 | XC8102AA01MR-G | XC8102_SOT-25_TOR | 1 |  | XC8102AA01MR-G
U7 | OPA836IDBVT | DBV0006A_L | 1 | Texas Instruments | OPA836IDBVT
U8 | IIS2DHTR | FP-LGA-12-8365767-MFG | 1 | STMicroelectronics | IIS2DHTR
X1 | ABS07AIG-32.768KHZ-9-1-T | Crys_Abracon_ABS07AIG-32_768KHZ-9-1-T_eec_MFG | 1 |  | ABS07AIG-32.768KHZ-9-1-T
X2 | FA-128 32.0000MF10Z-AJ3 | Crys_Seiko_Epson_Corporation_FA-128_32.0000MF10Z-AJ3_eec_0 | 1 |  | FA-128 32.0000MF10Z-AJ3
X3 | FY0800018 | XTAL_ECS-80-18-30B-AGN-TR | 1 | Diodes | FY0800018
X4 | ABS07-32.768KHZ-9-T | XTAL320X150X90 | 1 | Abracon | ABS07-32.768KHZ-9-T
Y1 | AWSCR-8.00CV-T | AWSCR-8.00CV-T_ABR | 1 |  | AWSCR-8.00CV-T
