thuer-awesome/wulpus/hardware/wulpus-pro/polycmut-adapter/manufacturing/jlcpcb/03_Reference/3D_STEP/interposer_pcb.step

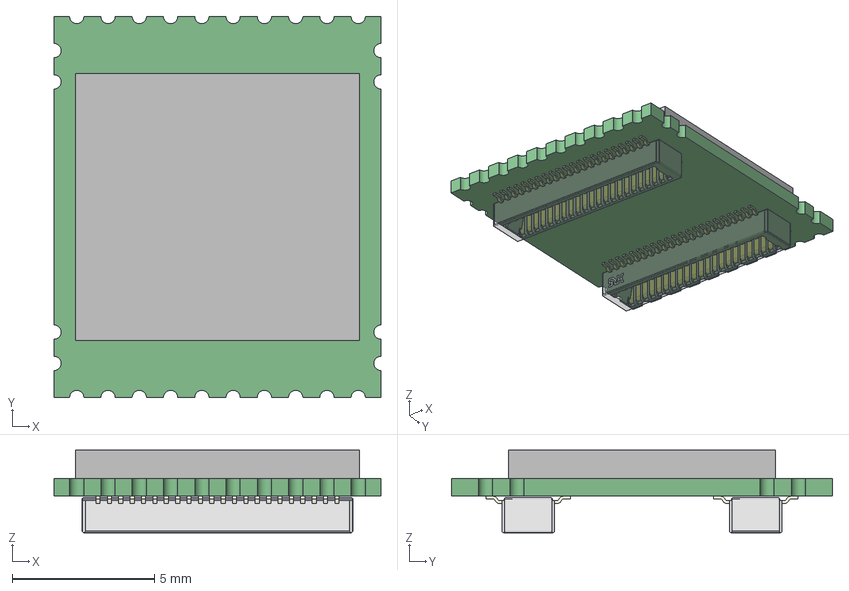
[picture p1: CAD file, 2026-08-27]
hardware/wulpus-pro/polycmut-adapter/manufacturing/jlcpcb/03_Reference/3D_STEP/interposer_pcb.step
11.5 x 13.4 x 2.91 mm
Hirose Electric x 2
Extruded
