thuer-awesome/wulpus/hardware/wulpus-pro/polycmut-adapter/manufacturing/jlcpcb/03_Reference/3D_STEP/flexypin.step

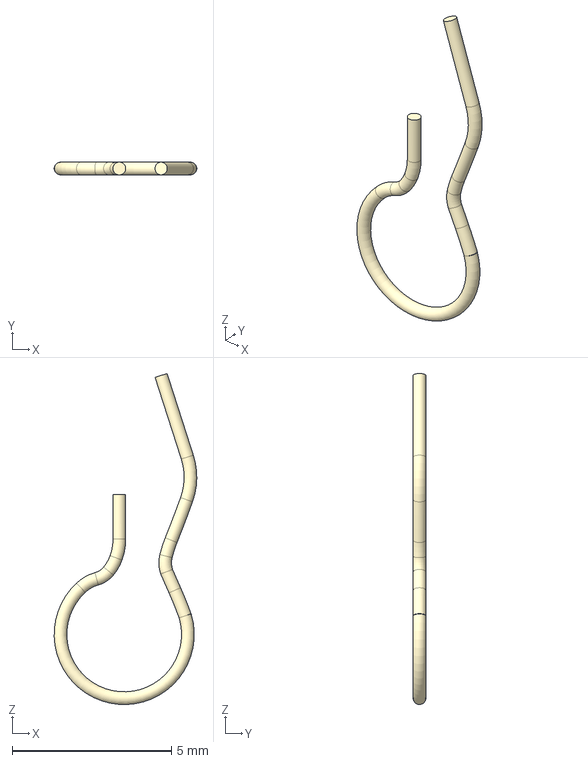
[picture p2: CAD file, 2026-08-27]
hardware/wulpus-pro/polycmut-adapter/manufacturing/jlcpcb/03_Reference/3D_STEP/flexypin.step
4.48 x 0.4 x 10.4 mm
