thuer-awesome/wulpus/(list of files, cad)

Other CAD files:
hardware/wulpus-v1/silicone-package/source/wulpus_outside_mold_fdm.stl
hardware/wulpus-v1/silicone-package/source/wulpus_outside_mold_resin.stl
hardware/wulpus-v1/silicone-package/source/wulpus_inside_mold_fdm.stl
hardware/wulpus-v1/silicone-package/source/wulpus_inside_mold_resin.stl
hardware/wulpus-v1/silicone-package/source/wulpus_silicone_cap_mold.stl
