thuer-awesome/wulpus/docs/manuals/wulpus-v1/README.md

# Folder for the documentation
In this folder you can find the official wulpus user manual and the photos of the system.
