thuer-awesome/wulpus/docs/manuals/wulpus-v1/images/README.md

# Images

## Authors
- [Frank K. Gürkaynak, ETH Zurich](https://iis-people.ee.ethz.ch/~kgf/) (*.jpg files in `./v1_0`)
- [Sergei Vostrikov, ETH Zurich](https://scholar.google.com/citations?user=a0KNUooAAAAJ&hl=en) (*.png files and the photos in `./v1_1`)

# Acknoledgment
We would like to recognize the help of [Victor Kartsch, ETH Zurich](https://scholar.google.it/citations?user=0LY6szsAAAAJ&hl=it) in preparing the media content for WULPUS v1.1 release.

# License
The images are licensed under a [Creative Commons Attribution 4.0 International
License][cc-by].

[][cc-by]

[cc-by]: http://creativecommons.org/licenses/by/4.0/
[cc-by-image]: https://i.creativecommons.org/l/by/4.0/88x31.png
[cc-by-shield]: https://img.shields.io/badge/License-CC%20BY%204.0-lightgrey.svg
