thuer-awesome/wulpus/hardware/wulpus-pro/polycmut-adapter/source/wulpus_testbench_polycmut_flexypin.html

Reporting Options

# File in Newer Format

Date | : | 07/05/2025
Time | : | 12:06:18
Filename | : | C:\Users\serge\Documents\repos\wulpus-pro\hw\wulpus_polycmut_adapter\wulpus_testbench_polycmut_flexypin.PrjPcb

Version | Warning

Release 23.10

CAUTION - This project contains rules defined using the Constraint Manager. You are seeing this message for two possible reasons. Firstly, this is an older version of the software that does not support this feature, in which case design rules will fall back to being presented as standard, query-based rules. If you save the PCB project in this older version of Altium Designer, all Constraint Manager data structure information will be lost. Secondly, if this software version does support the feature, then you currently don't have the level of Altium Designer Software Subscription (Pro/Enterprise) to be able to edit constraints using the Constraint Manager, in which case it will present rules in view only mode.

This file was generated by a later version of the software
