thuer-awesome/wulpus/CHANGELOG.md

# Changelog

## [0.1.0] - 2026-08-27

### Added

- Consolidated the four WULPUS v1 boards, silicone package, WULPUS PRO boards, official firmware, and host software into a board-oriented tree.
- Added unpacked JLCPCB packages, board-specific fabrication ZIPs, assembly references, stackups, BOM/CPL files, and manual-solder checklists.
- Added the 2026-08-23 Y19/Y20 missing-component audit (25 verified SMT positions), LCSC decision notes, source hashes, and deterministic repository manifests.
- Added provenance, licensing, safety, contribution, security, issue/PR templates, and CI validation.
- Added the separate 9959 Control Integrated Board handover under `projects/` without mixing it into WULPUS hardware.

### Source snapshots

- `pulp-bio/wulpus` `main` at `48a913c9c20c5220b92e19e274565a9e9881cee6` (2026-06-21).
- `pulp-bio/wulpus-pro` `dev` at `d49cf62a53e260d7670d7375b2f6ca3aad627ea7` (2025-11-08).
