thuer-awesome/wulpus/hardware/wulpus-v1/silicone-package/source/CHANGELOG.md

# Changelog

All notable changes to this project will be documented in this file.

The format is based on [Keep a Changelog](https://keepachangelog.com/en/1.0.0/),
and this project adheres to [Semantic Versioning](https://semver.org/spec/v2.0.0.html).

## [1.2.0] - 2025-01-27

### Added
- Design files for WULPUS silicone package
- Manufacturing instruction for silicone package in the WULPUS User Manual
### Fixed
### Changed
### Removed
