thuer-awesome/wulpus/docs/manuals/wulpus-v1/CHANGELOG.md

# Changelog

All notable changes to this project will be documented in this file.

The format is based on [Keep a Changelog](https://keepachangelog.com/en/1.0.0/),
and this project adheres to [Semantic Versioning](https://semver.org/spec/v2.0.0.html).

## [1.2.0] - 2025-01-27

### Added
- Fabrication instructions for the WULPUS silicone package (refer to WULPUS User Manual Rev. 2).

### Fixed
- Resolved multiple inaccuracies in WULPUS User Manual (#13, #15, #18, #22).  

## [1.1.0] - 2024-02-21

### Added

- WULPUS user manual Rev 1.
- Added the new photos of the WULPUS PCBs v1.1 folder into the dedicated subfolder (`./images/v1_1`).

### Fixed

### Changed

- Moved `./images` folder into the dedicated subfolder (`./images/v1_0`)

### Removed
