thuer-awesome/wulpus/(list of files, drawings)

Other design files:
hardware/wulpus-pro/acquisition-dev-board/source/host_connector.SchDoc
hardware/wulpus-pro/acquisition-dev-board/source/hv_mux_tr_sw.SchDoc
hardware/wulpus-pro/acquisition-dev-board/source/main.SchDoc
hardware/wulpus-pro/acquisition-dev-board/source/msp430.SchDoc
hardware/wulpus-pro/acquisition-dev-board/source/power.SchDoc
hardware/wulpus-pro/acquisition-dev-board/source/rx_path.SchDoc
hardware/wulpus-pro/acquisition-dev-board/source/rx_path_lp_filter.SchDoc
hardware/wulpus-pro/acquisition-dev-board/source/tx_path.SchDoc
hardware/wulpus-pro/acquisition-dev-board/source/wulpus_pro_acq.PcbDoc
hardware/wulpus-pro/acquisition-dev-board/source/wulpus_pro_acq_pcb.PrjPcb
hardware/wulpus-pro/polycmut-adapter/source/PCB1.PcbDoc
hardware/wulpus-pro/polycmut-adapter/source/PcbLib1.PcbLib
hardware/wulpus-pro/polycmut-adapter/source/Sheet1.SchDoc
hardware/wulpus-pro/polycmut-adapter/source/wulpus_testbench_polycmut_flexypin.PrjPcb
hardware/wulpus-v1/acquisition-pcb/source/00_POWER.SchDoc
hardware/wulpus-v1/acquisition-pcb/source/01_NRF52.SchDoc
hardware/wulpus-v1/acquisition-pcb/source/02_MSP430.SchDoc
hardware/wulpus-v1/acquisition-pcb/source/03_MSP430_AFE.SchDoc
hardware/wulpus-v1/acquisition-pcb/source/04_MR_WOLF.SchDoc
hardware/wulpus-v1/acquisition-pcb/source/05_IMU.SchDoc
hardware/wulpus-v1/acquisition-pcb/source/PCB1.PcbDoc
hardware/wulpus-v1/acquisition-pcb/source/PcbLib1.PcbLib
hardware/wulpus-v1/acquisition-pcb/source/Schlib1.SchLib
hardware/wulpus-v1/acquisition-pcb/source/wulpus_acq_pcb.PrjPcb
hardware/wulpus-v1/hv-pcb/source/00_POWER.SchDoc
hardware/wulpus-v1/hv-pcb/source/01_TRANSDUCERS.SchDoc
hardware/wulpus-v1/hv-pcb/source/PCB1.PcbDoc
hardware/wulpus-v1/hv-pcb/source/PcbLib1.PcbLib
hardware/wulpus-v1/hv-pcb/source/Schlib1.SchLib
hardware/wulpus-v1/hv-pcb/source/wulpus_hv_mux.PrjPcb
