thuer-awesome/wulpus/(commit log)

2026-08-27 chore: consolidate WULPUS hardware and embedded sources
    [00_POWER.SchDoc, 01_NRF52.SchDoc, 01_TRANSDUCERS.SchDoc, 02_MSP430.SchDoc, 03_MSP430_AFE.SchDoc, 04_COMPONENT_CROSS_REFERENCE.csv, 04_MR_WOLF.SchDoc, 05_IMU.SchDoc]
2026-08-27 chore: ignore generated Python caches in manifests
    [FILE_MANIFEST.csv]
2026-08-27 docs: preserve package metadata and manufacturing archives
    [FILE_MANIFEST.csv]
2026-08-27 docs: add dedicated repository publishing checklist
    [FILE_MANIFEST.csv]
2026-08-27 fix: make provenance and GUI entrypoints reproducible
    [FILE_MANIFEST.csv, SOURCE_FILE_MAP.csv]
2026-08-27 chore: refresh manifests after publication merge
    [FILE_MANIFEST.csv]
2026-08-27 docs: add standard domain navigation
    [FILE_MANIFEST.csv]
2026-08-27 docs: record GitHub publication target
    [FILE_MANIFEST.csv]
2026-08-27 docs: point citation metadata to integration repository
    [FILE_MANIFEST.csv]
2026-08-27 docs: redact private local provenance paths
    [FILE_MANIFEST.csv]
2026-08-27 ci: validate GUI entries and LFS payloads
    [FILE_MANIFEST.csv]
2026-08-27 fix: exclude ignored runtime files from manifests
    [FILE_MANIFEST.csv]
